gabref/TCC/diversos/base-Análise estática 1-Resultados-Tensão1.analysis.png

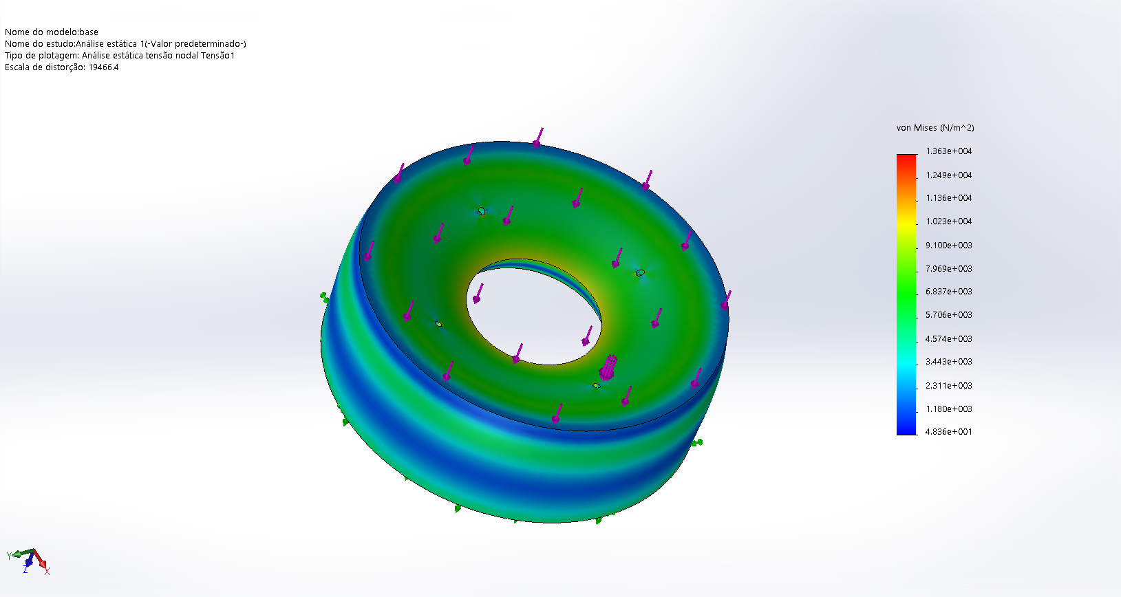
diversos/base-Análise estática 1-Resultados-Tensão1.analysis.png
