gabref/TCC/diversos/Análise estática Braço 200mm-Resultados-Deslocamento1.analysis.png

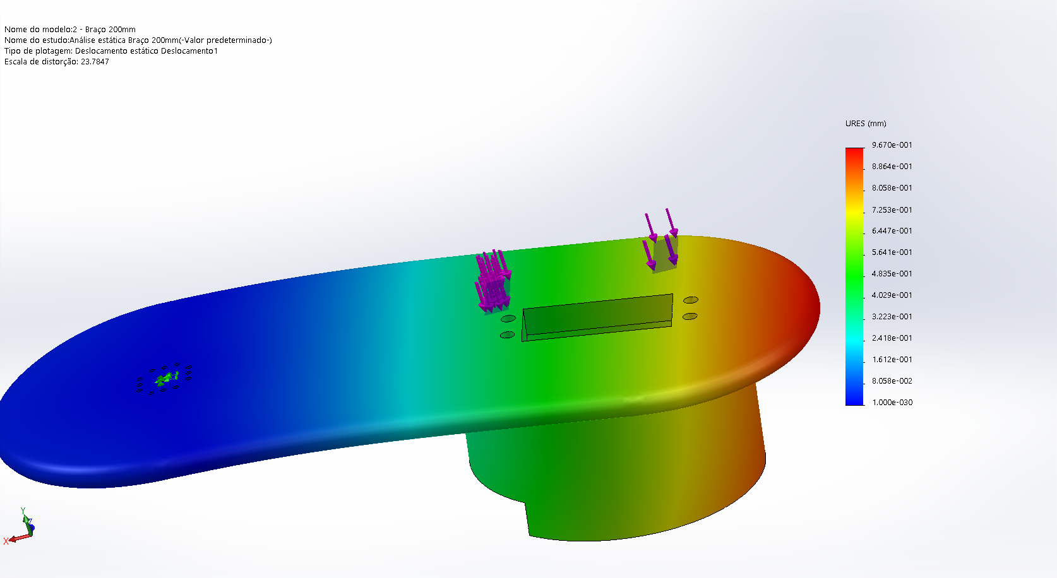
diversos/Análise estática Braço 200mm-Resultados-Deslocamento1.analysis.png
