gabref/TCC/README.md

# TCC
TCC de Mecatrônica - Colégio Técnico Opção (2017)
##
Para ler o PDF do TCC, acessar o link: [Pasta Entregue](https://github.com/gabref/TCC/blob/main/Pasta%20Entregue.pdf)

## Vídeo demonstrando o funcionamento do programa Desktop para controlar o Robô Scara-D

https://user-images.githubusercontent.com/83483325/134989432-be1a48b4-38d2-438e-9cfa-d54873dcd93e.mp4
