gabref/TCC/Desenhos Aprovados/Base da Coluna.jpg

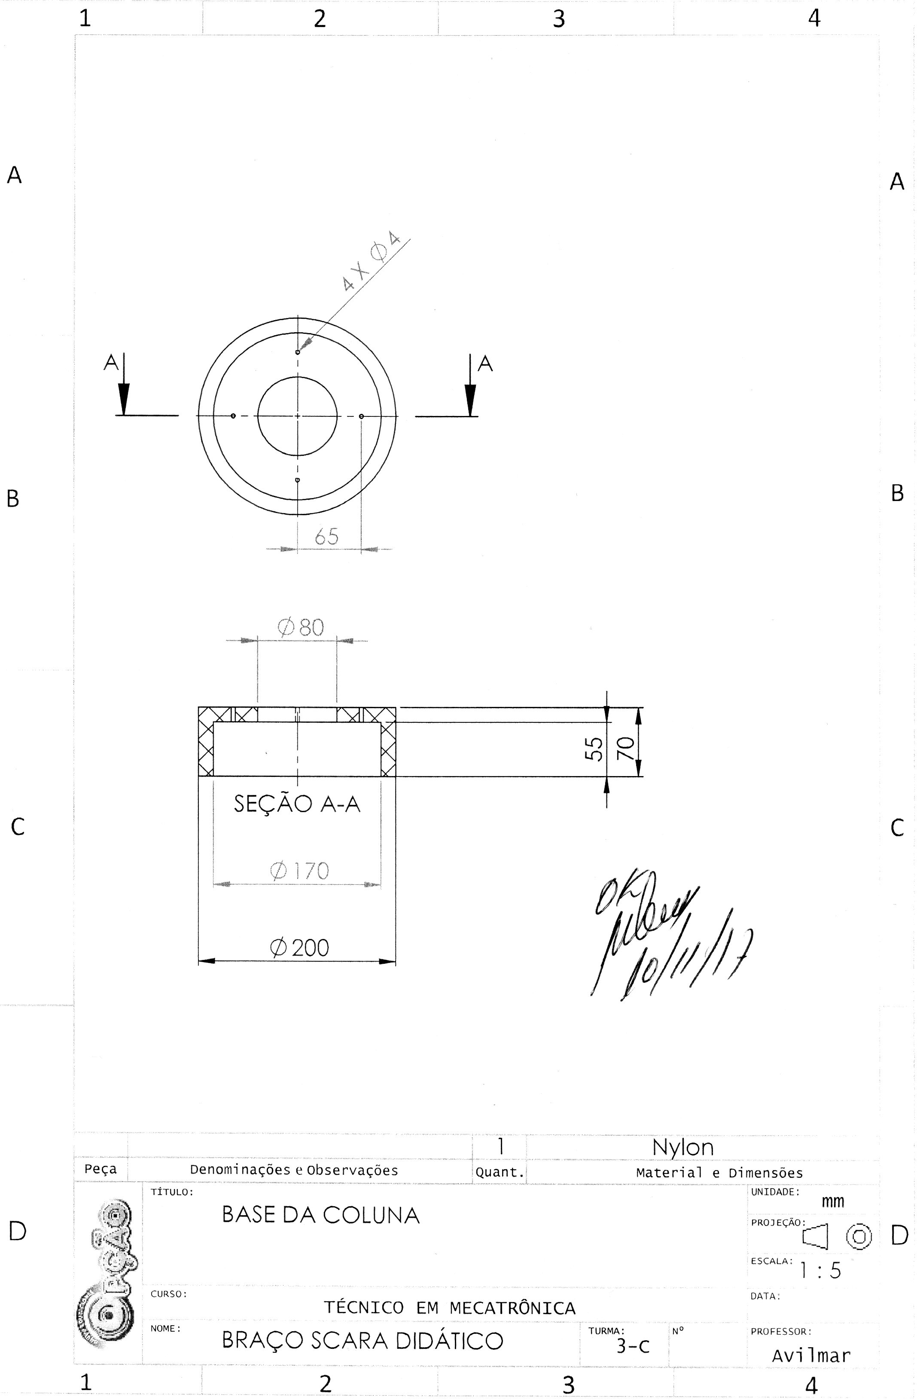
Desenhos Aprovados/Base da Coluna.jpg
