gabref/TCC/Desenhos Aprovados/Base Guarra.jpg

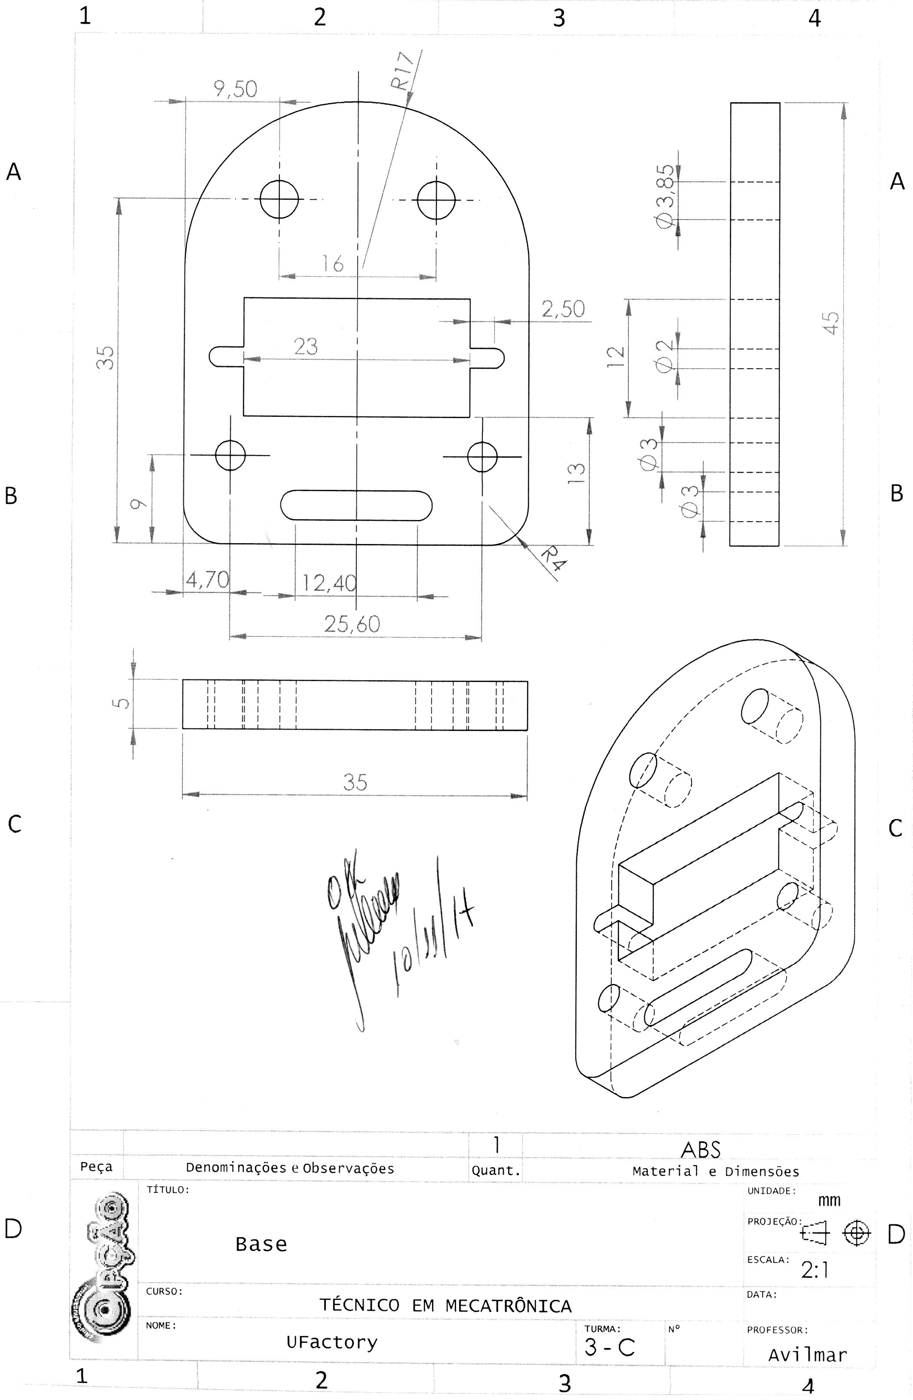
Desenhos Aprovados/Base Guarra.jpg
