gabref/TCC/Desenhos Aprovados/Circuito Elétrico.jpg

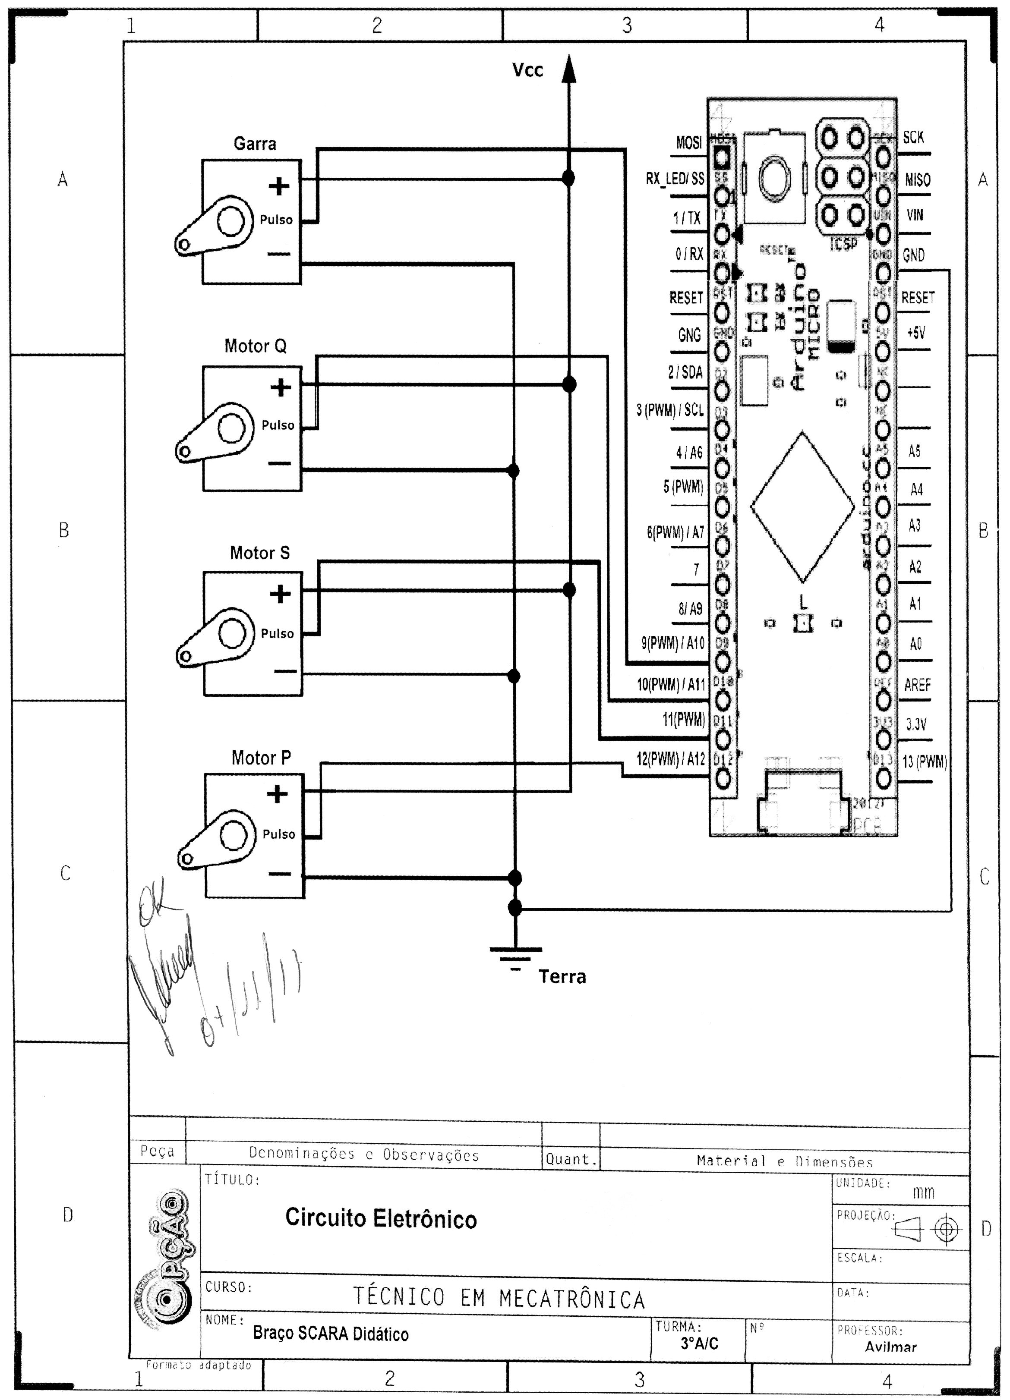
Desenhos Aprovados/Circuito Elétrico.jpg
