gabref/TCC/Desenhos Aprovados/Coluna.jpg

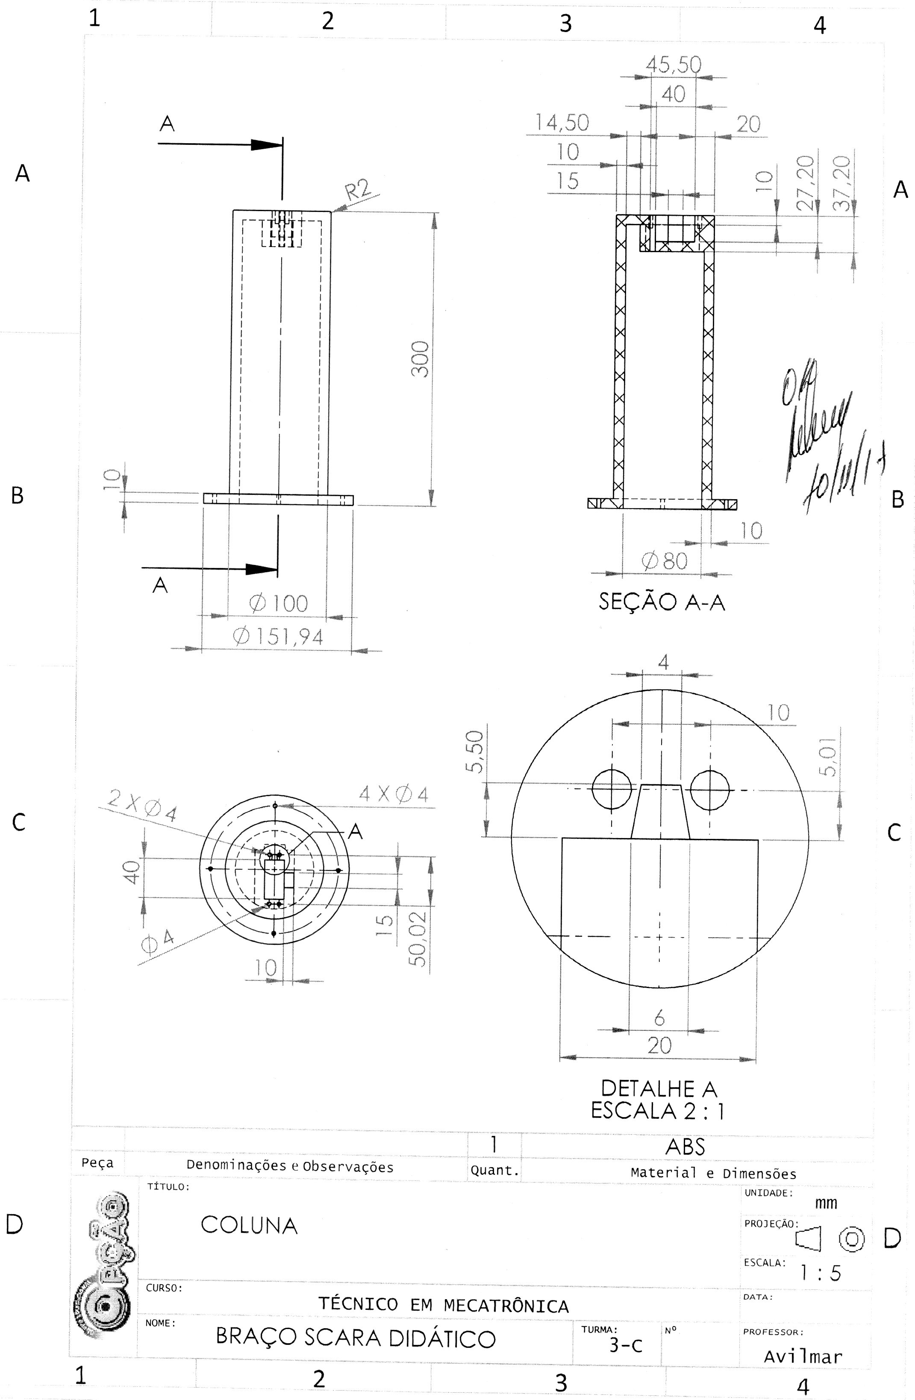
Desenhos Aprovados/Coluna.jpg
