gabref/TCC/Desenhos Aprovados/Conector da Garra.jpg

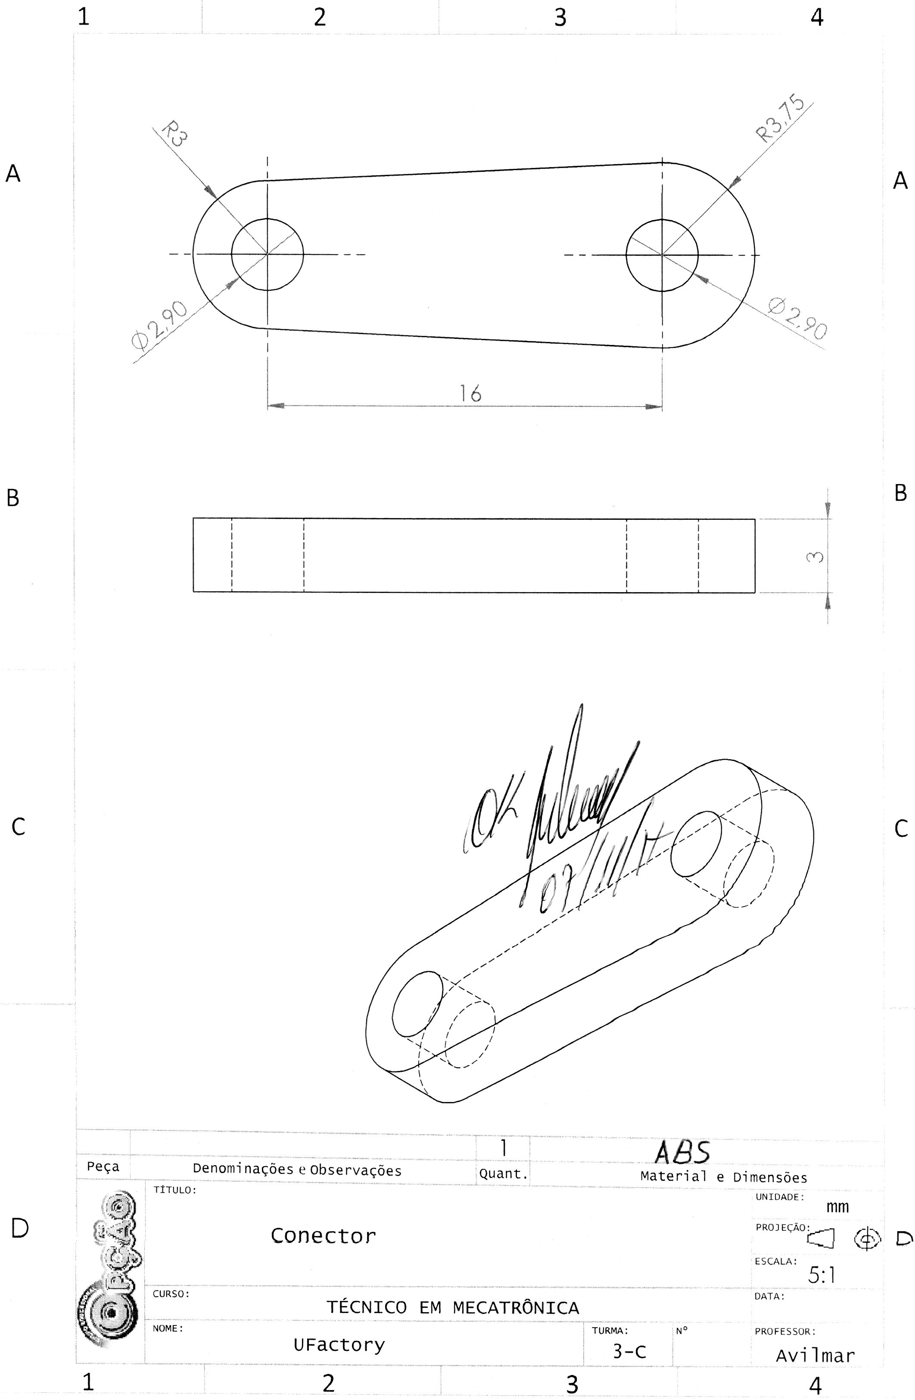
Desenhos Aprovados/Conector da Garra.jpg
