gabref/TCC/Desenhos Aprovados/Corpo da Junta Prismática.jpg

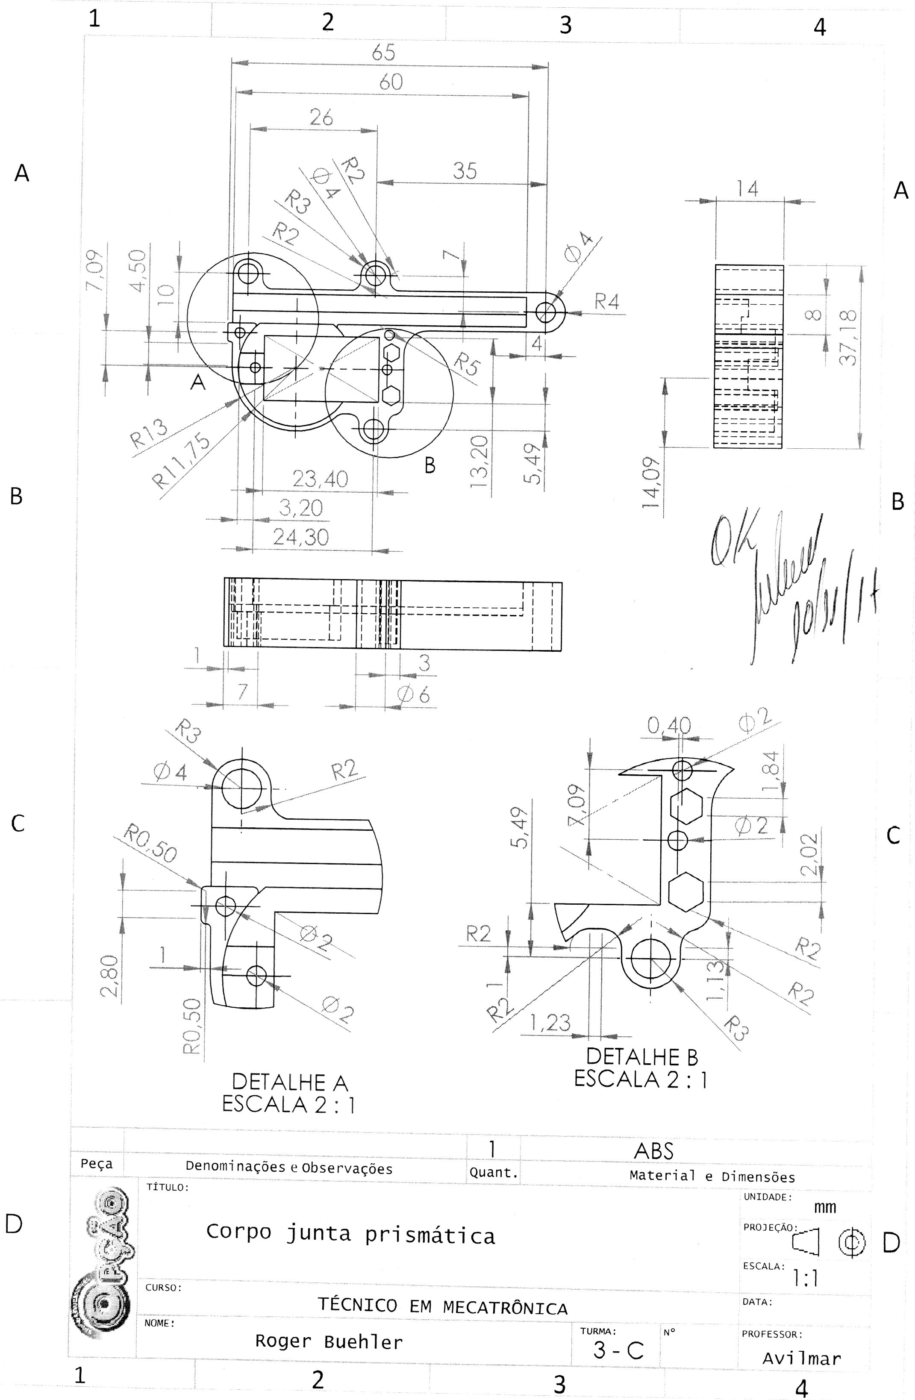
Desenhos Aprovados/Corpo da Junta Prismática.jpg
