gabref/TCC/Desenhos Aprovados/Cremalheira.jpg

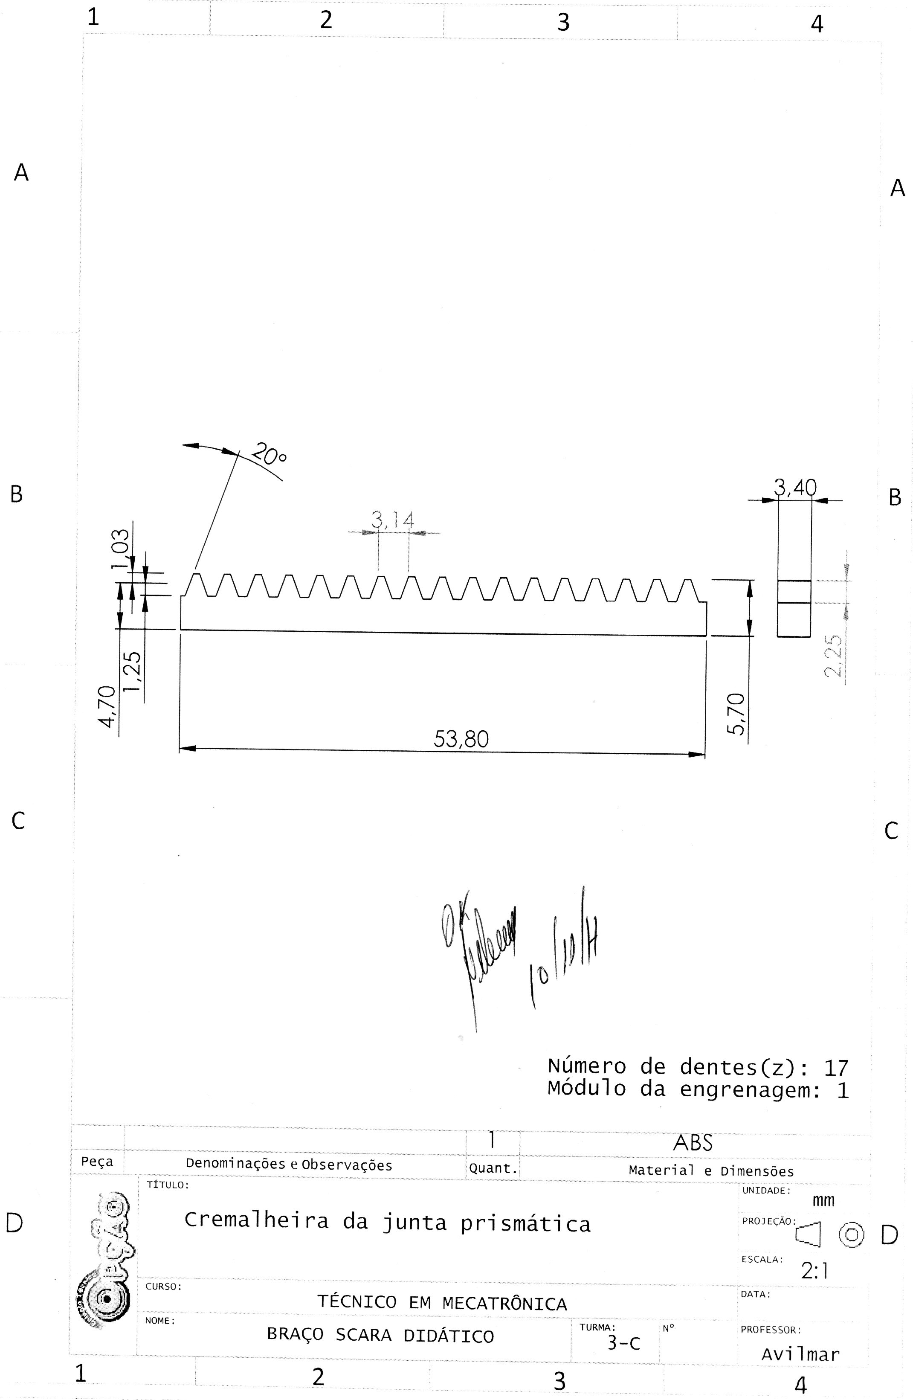
Desenhos Aprovados/Cremalheira.jpg
