gabref/TCC/Desenhos Aprovados/Elo 1.jpg

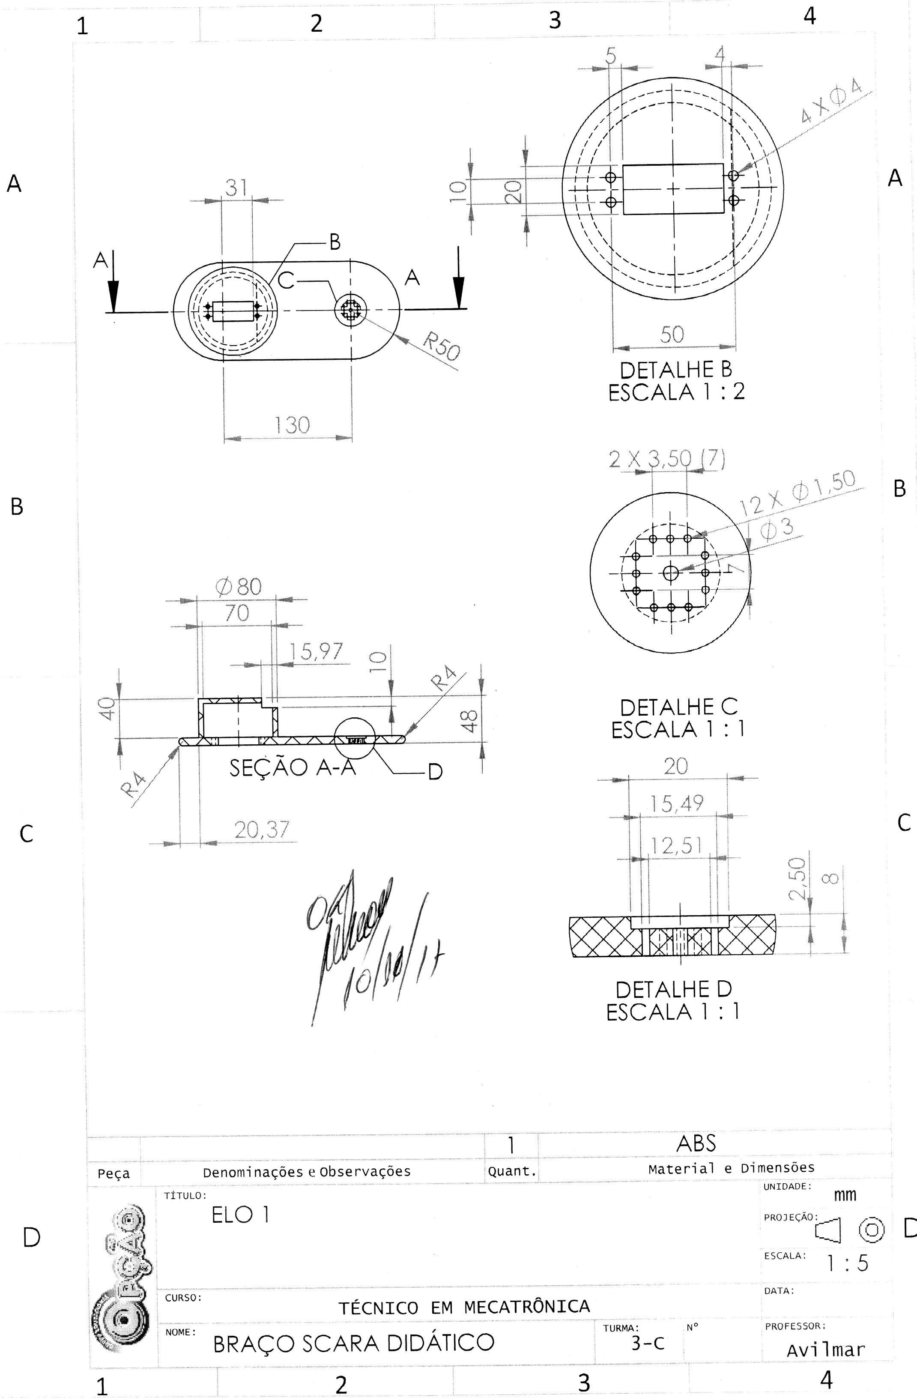
Desenhos Aprovados/Elo 1.jpg
