gabref/TCC/Desenhos Aprovados/Elo 2.jpg

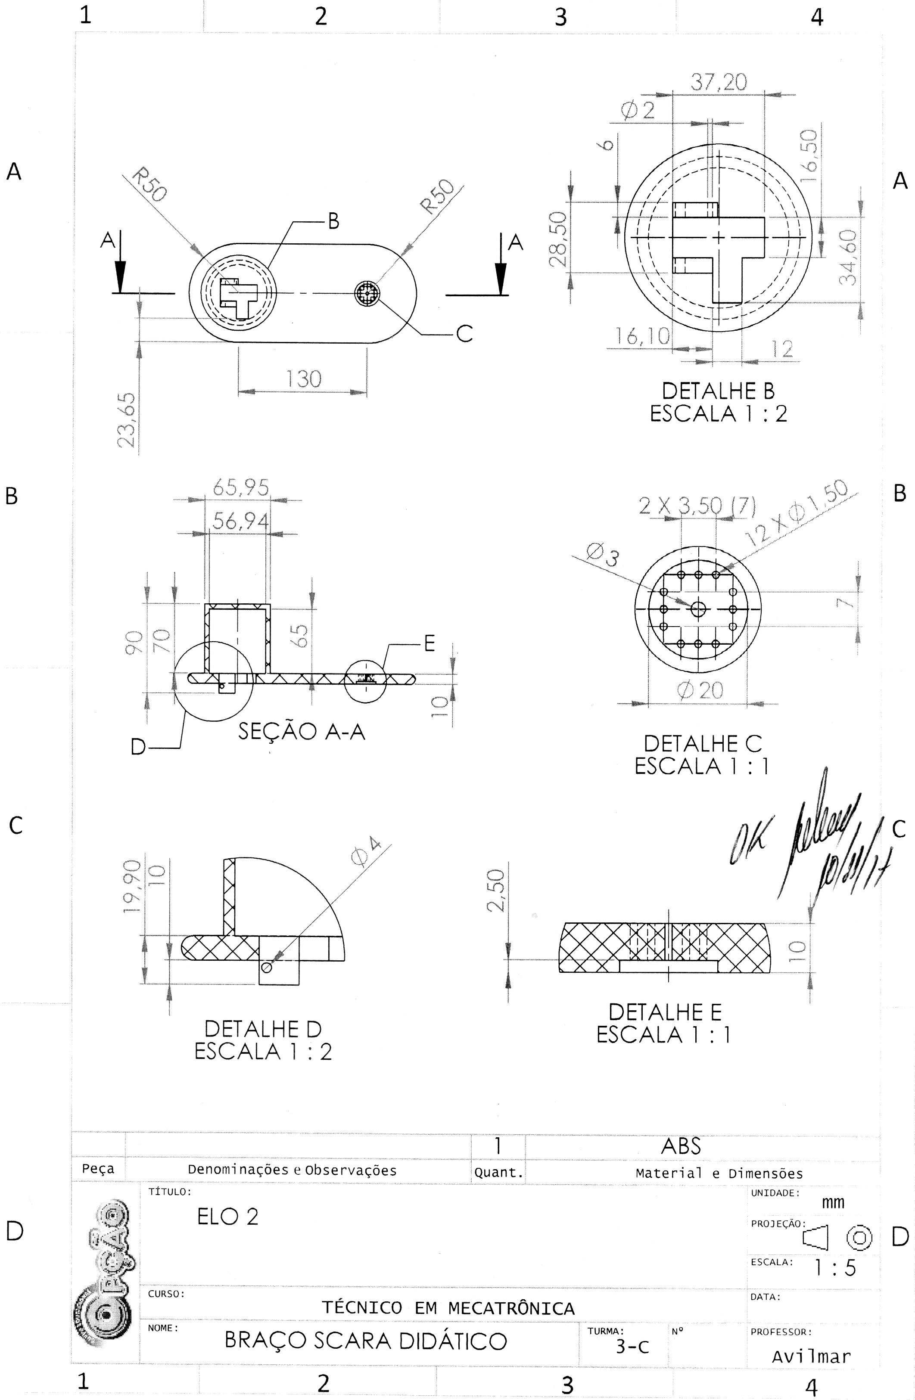
Desenhos Aprovados/Elo 2.jpg
