gabref/TCC/Desenhos Aprovados/Encaixe da Cremalheira.jpg

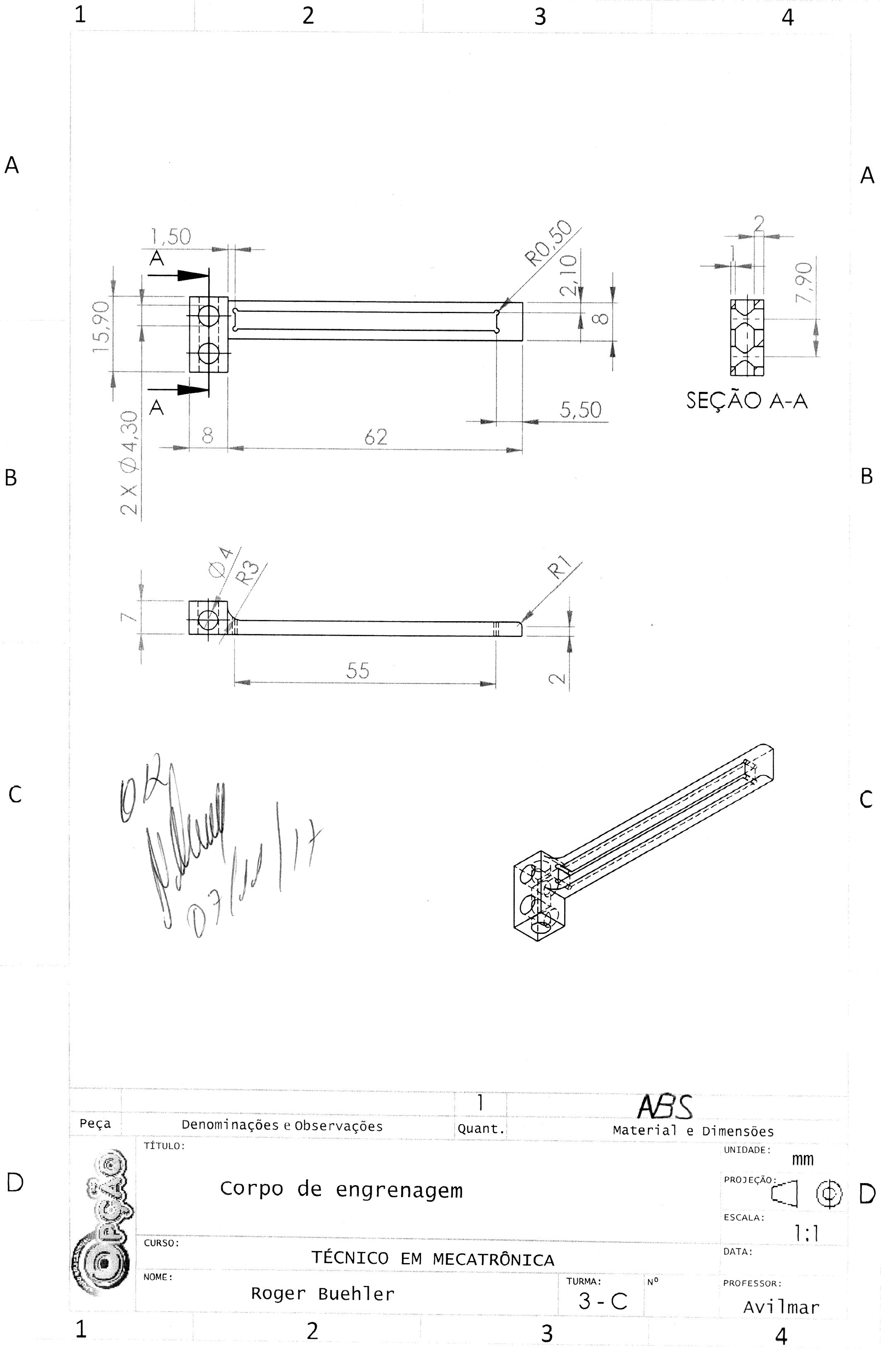
Desenhos Aprovados/Encaixe da Cremalheira.jpg
