gabref/TCC/Desenhos Aprovados/Encaixe da Junta Prismática.jpg

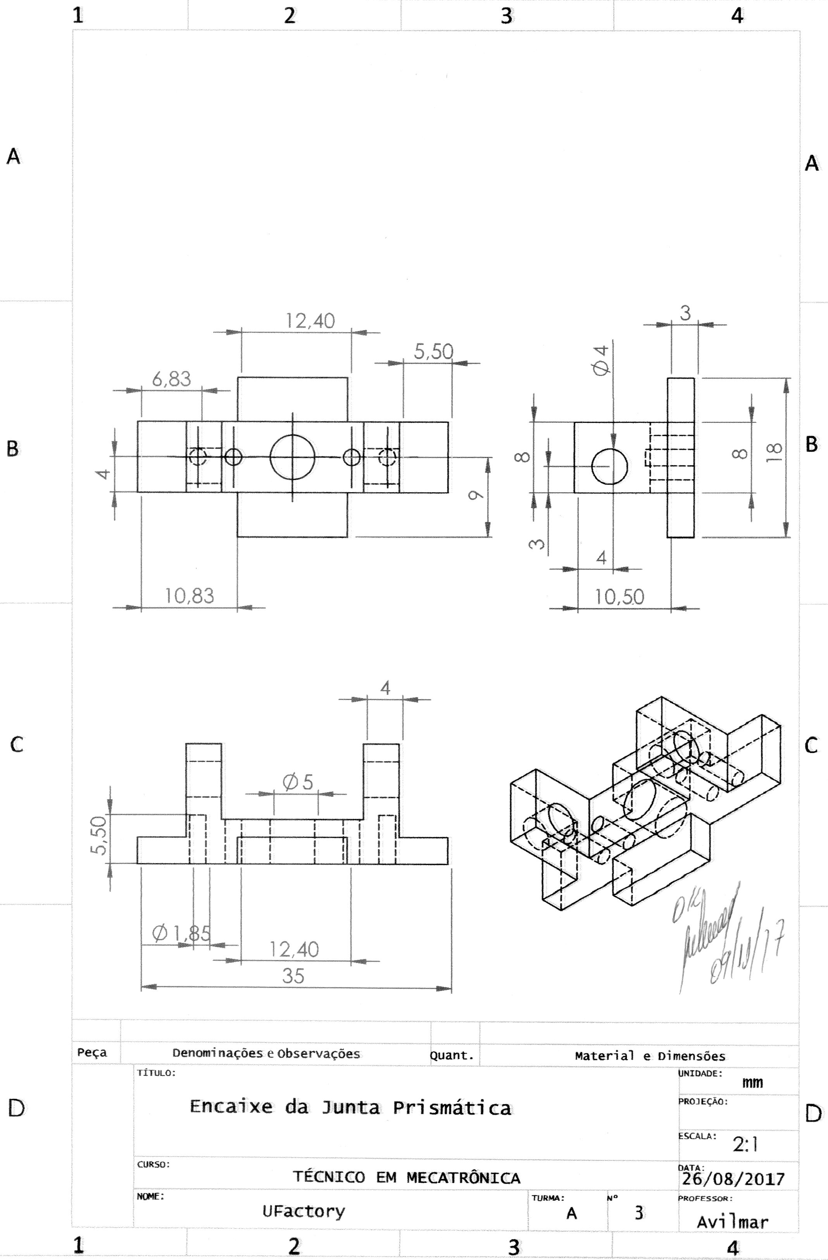
Desenhos Aprovados/Encaixe da Junta Prismática.jpg
