gabref/TCC/Desenhos Aprovados/Engrenagem.jpg

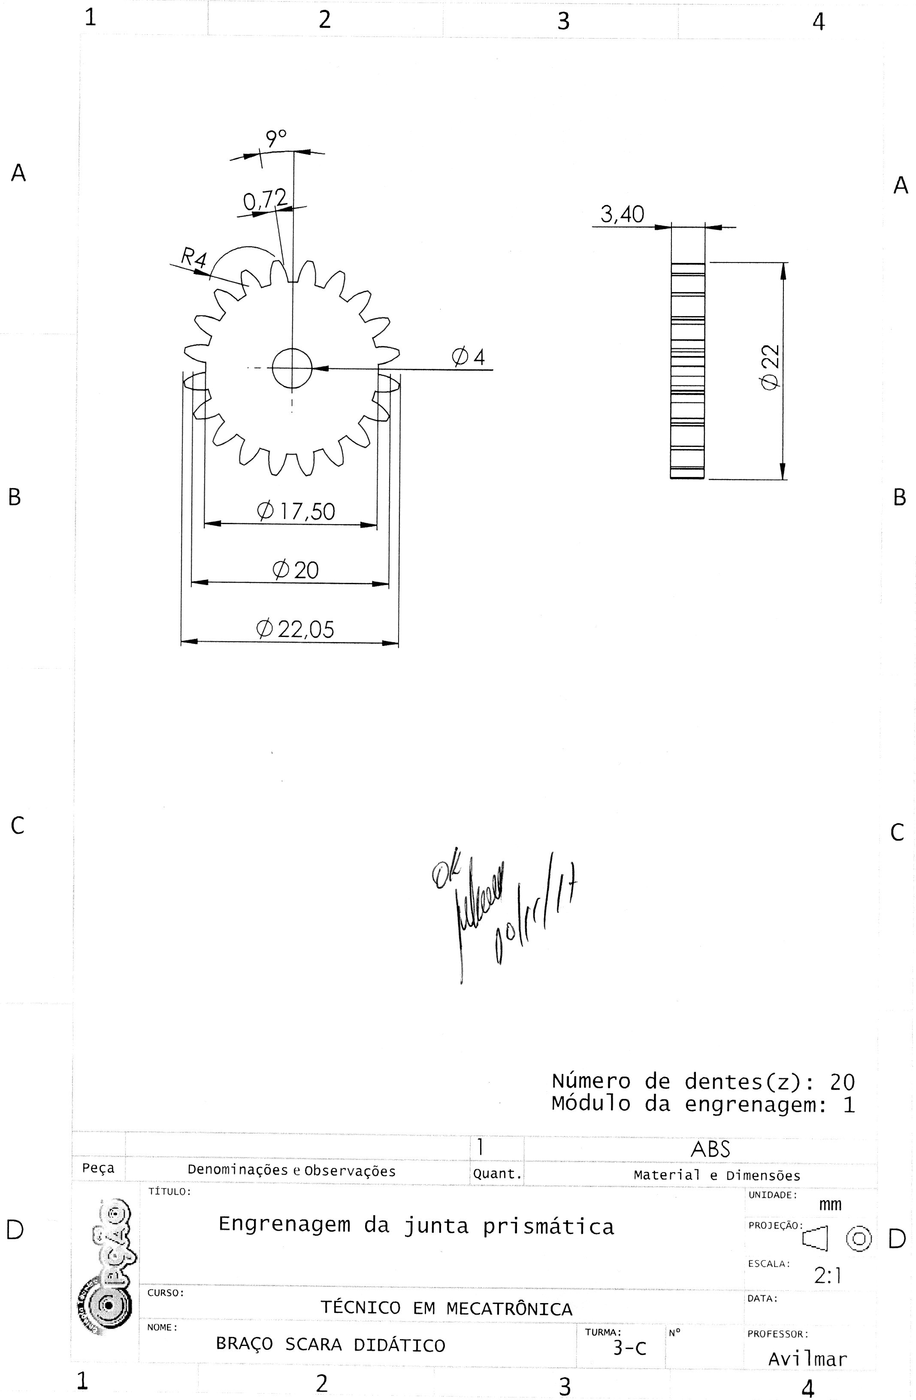
Desenhos Aprovados/Engrenagem.jpg
