gabref/TCC/Desenhos Aprovados/Espaçador da Garra.jpg

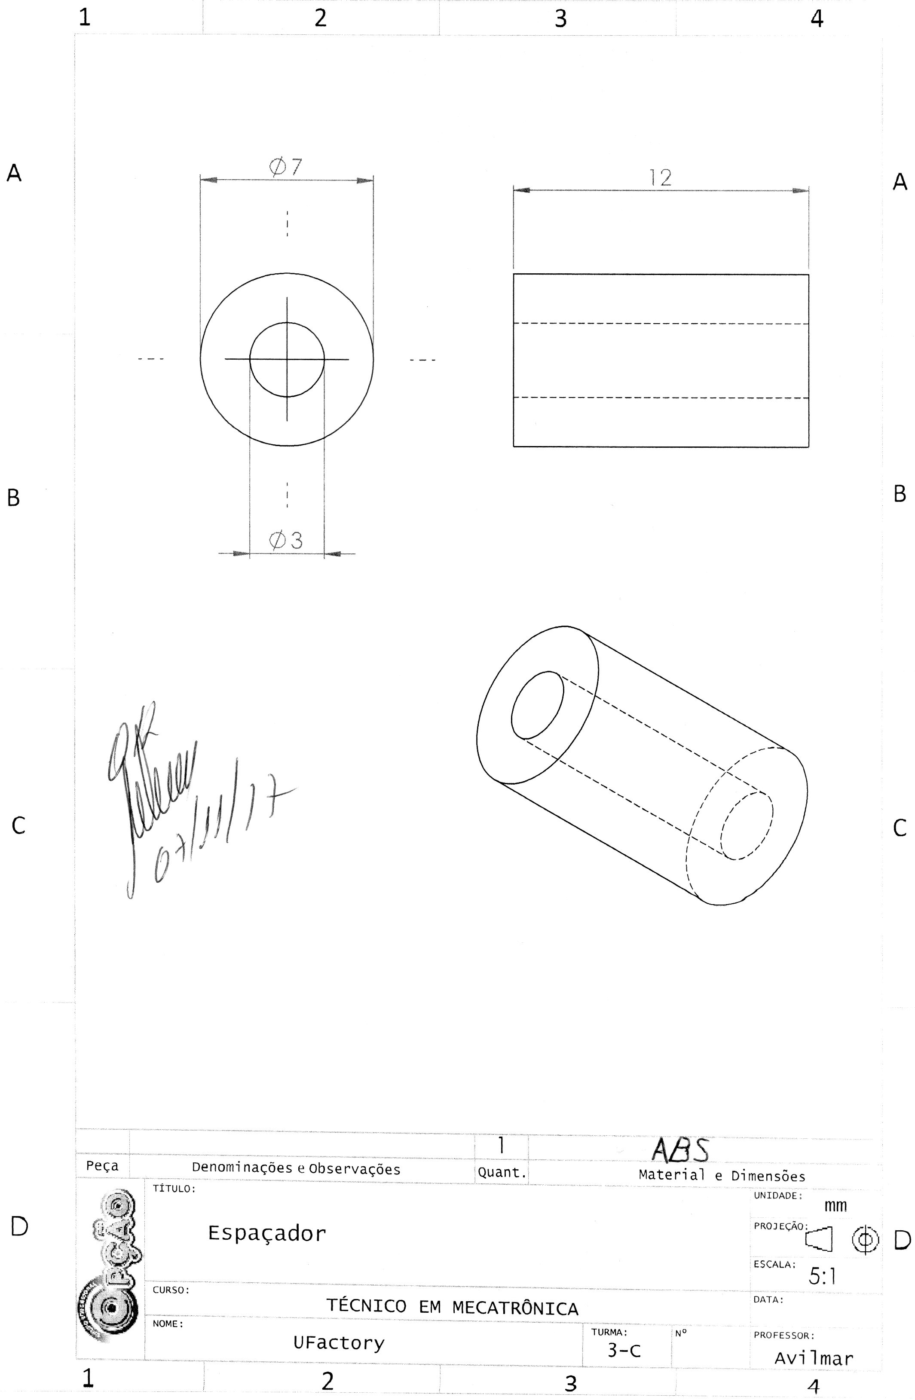
Desenhos Aprovados/Espaçador da Garra.jpg
