gabref/TCC/Desenhos Aprovados/Garra da Coroa.jpg

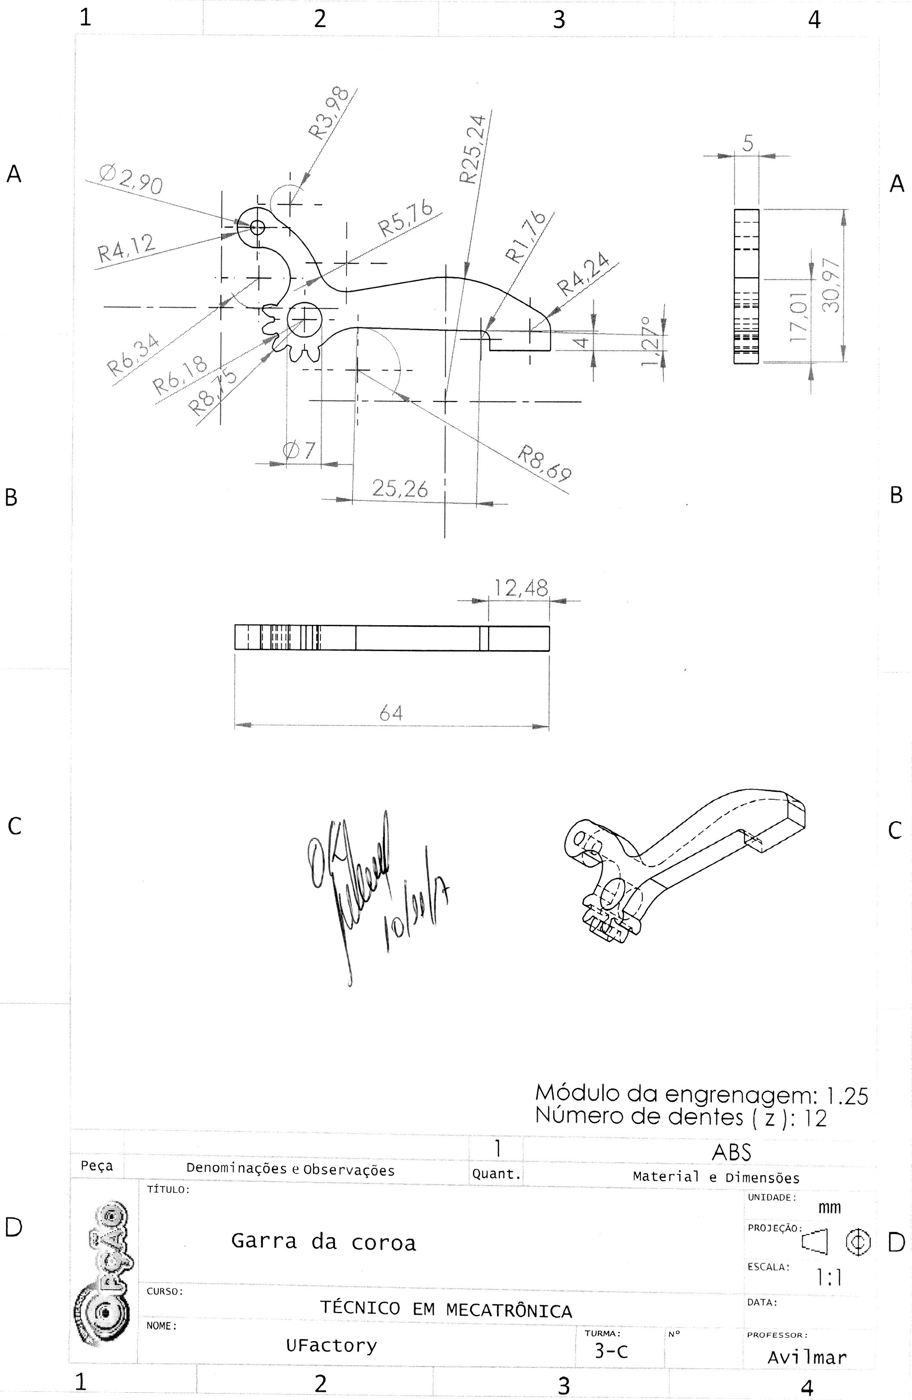
Desenhos Aprovados/Garra da Coroa.jpg
