gabref/TCC/Desenhos Aprovados/Garra do Pinhão.jpg

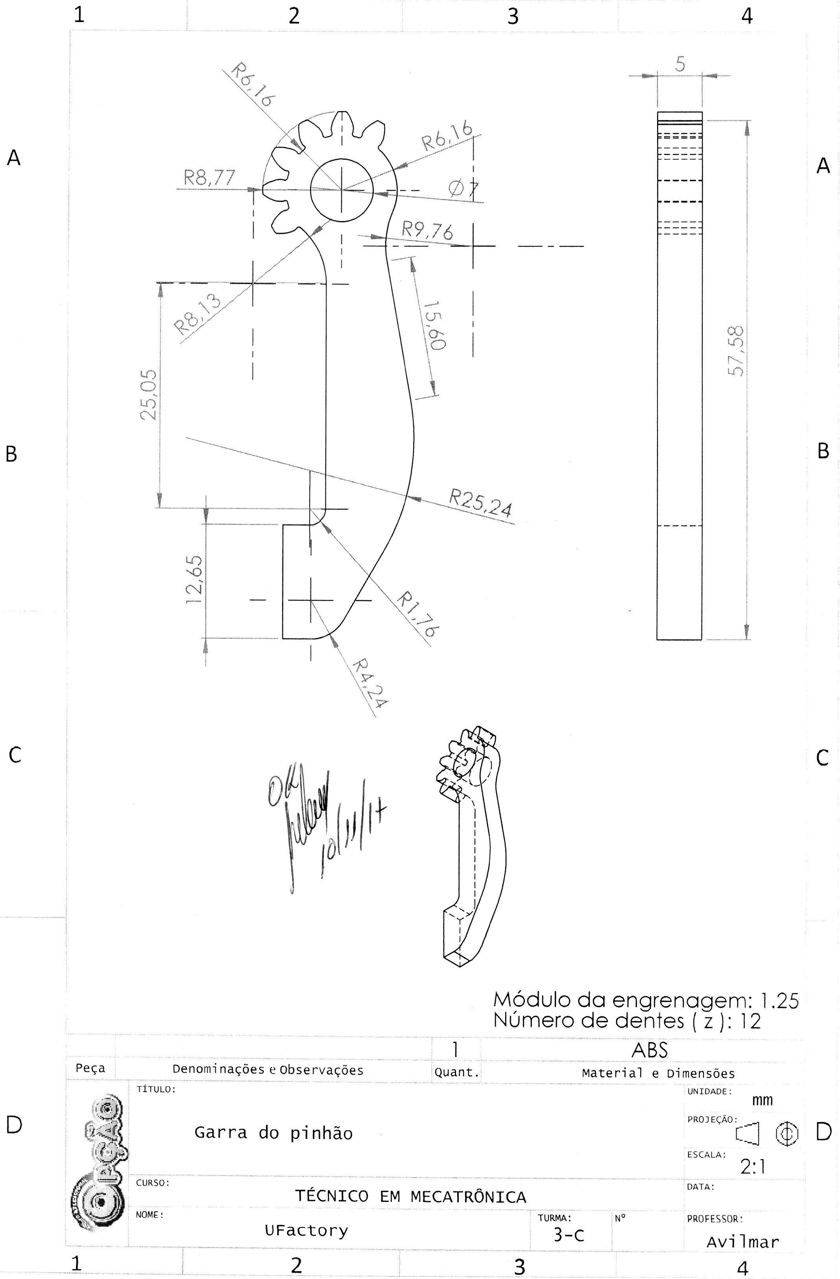
Desenhos Aprovados/Garra do Pinhão.jpg
