gabref/TCC/Desenhos Aprovados/Hélice Servo Motor.jpg

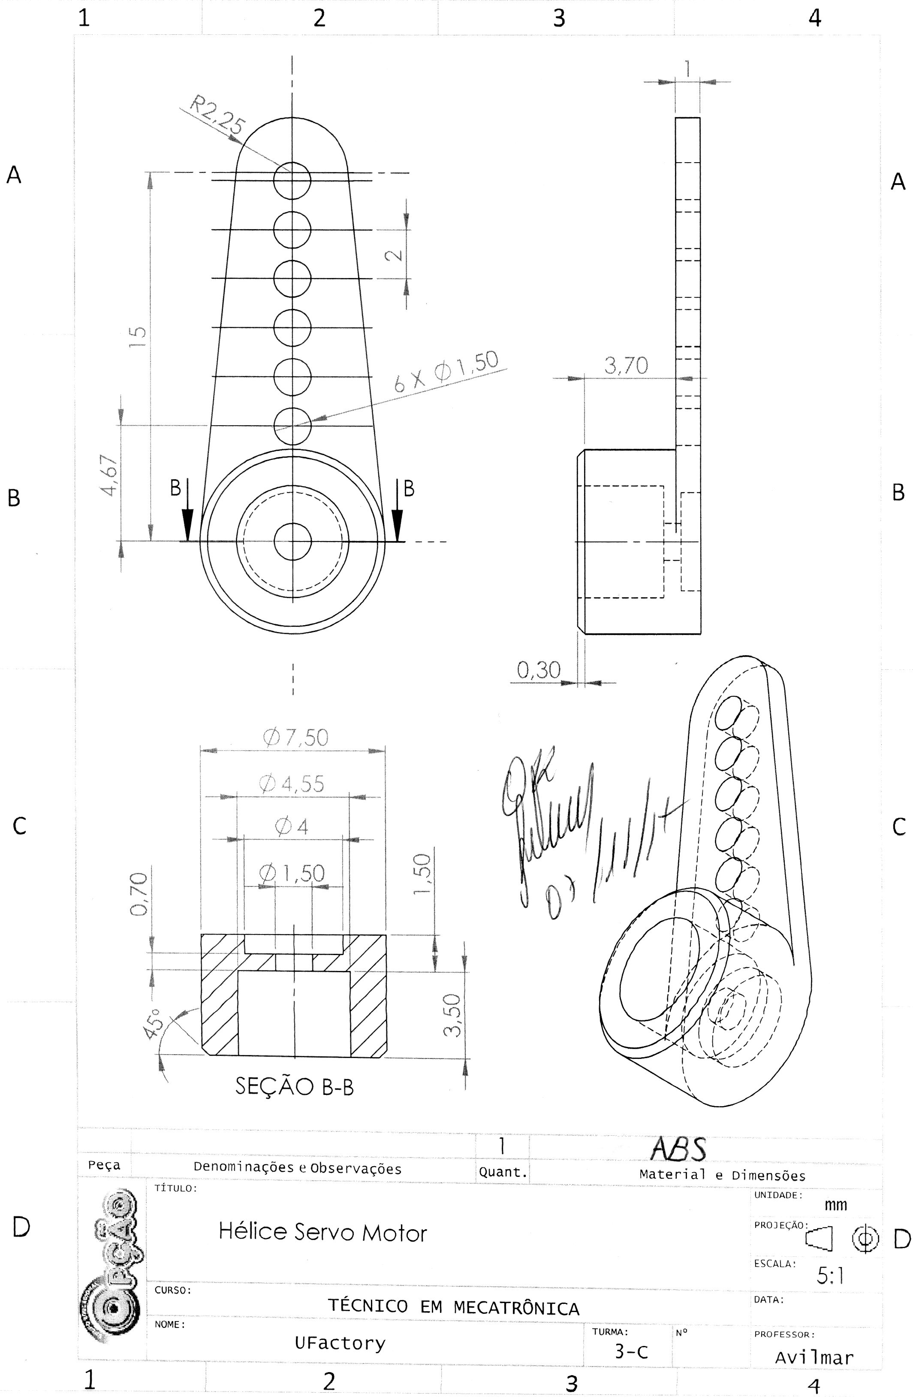
Desenhos Aprovados/Hélice Servo Motor.jpg
