gabref/TCC/Desenhos Aprovados/SCARA-D.jpg

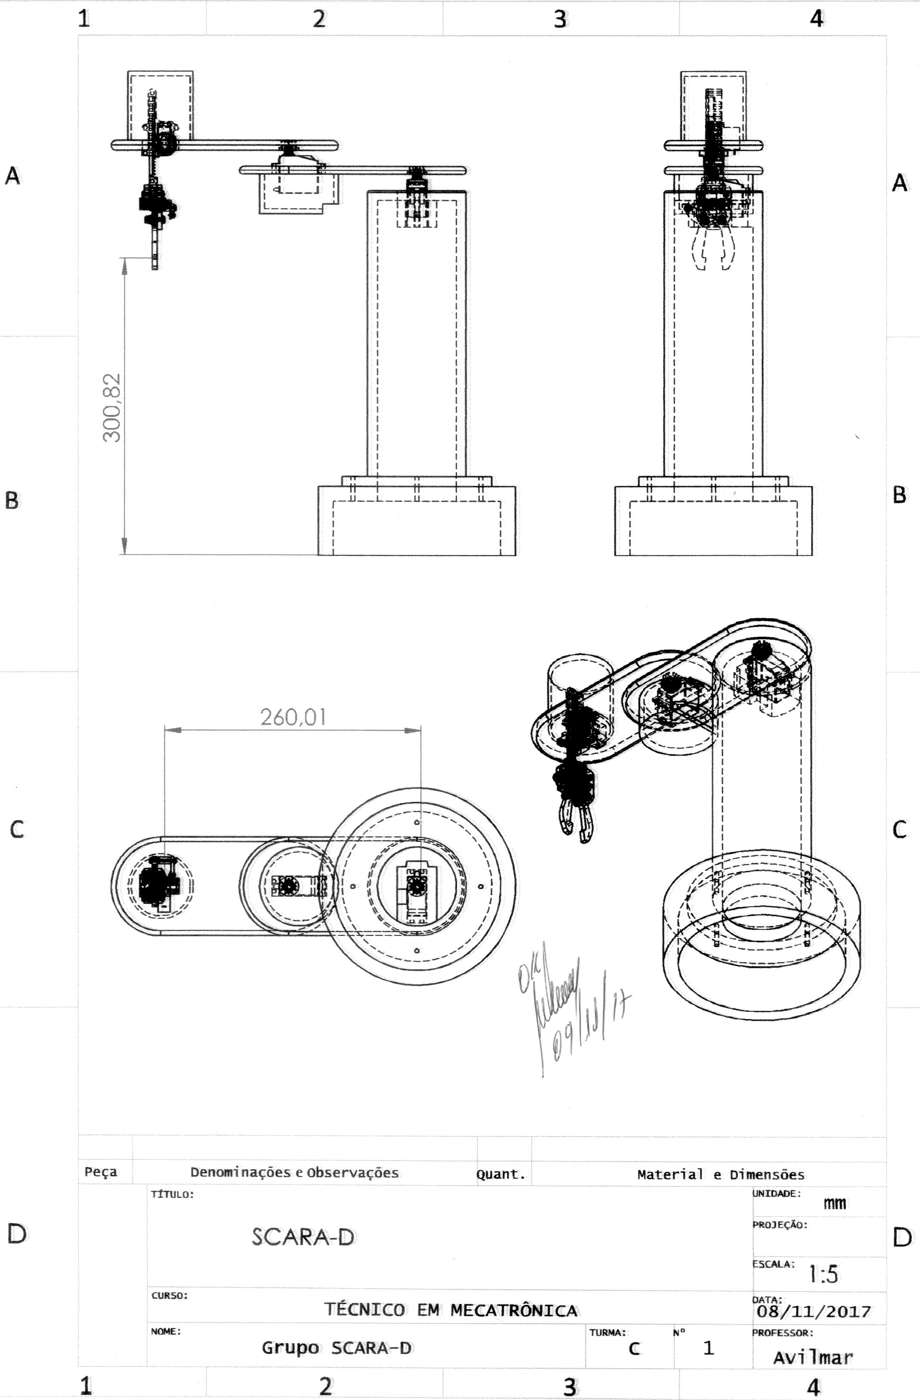
Desenhos Aprovados/SCARA-D.jpg
