gabref/TCC/Desenhos Aprovados/Suporte M3x8.jpg

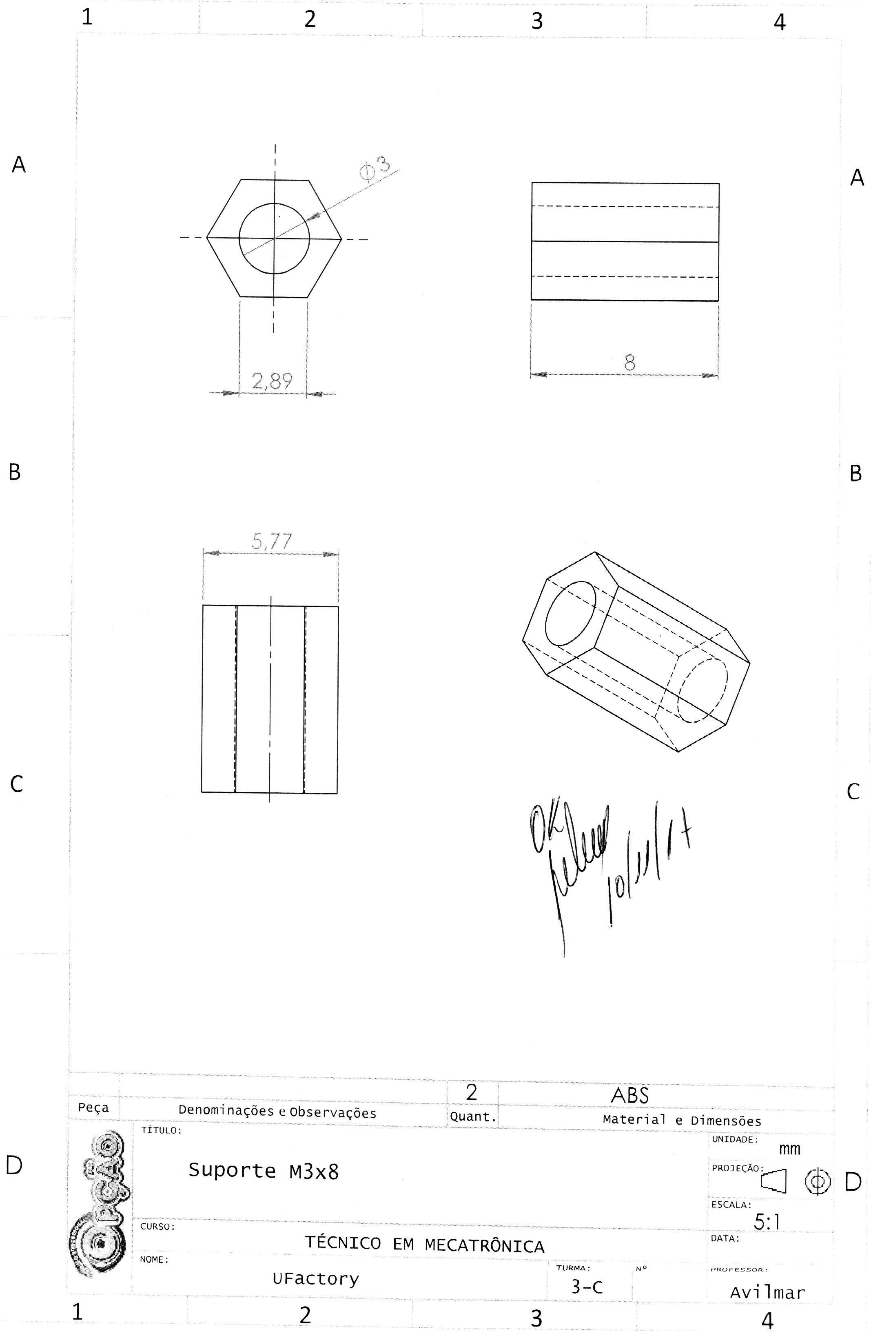
Desenhos Aprovados/Suporte M3x8.jpg
