gabref/TCC/Desenhos Aprovados/Suporte Servo.jpg

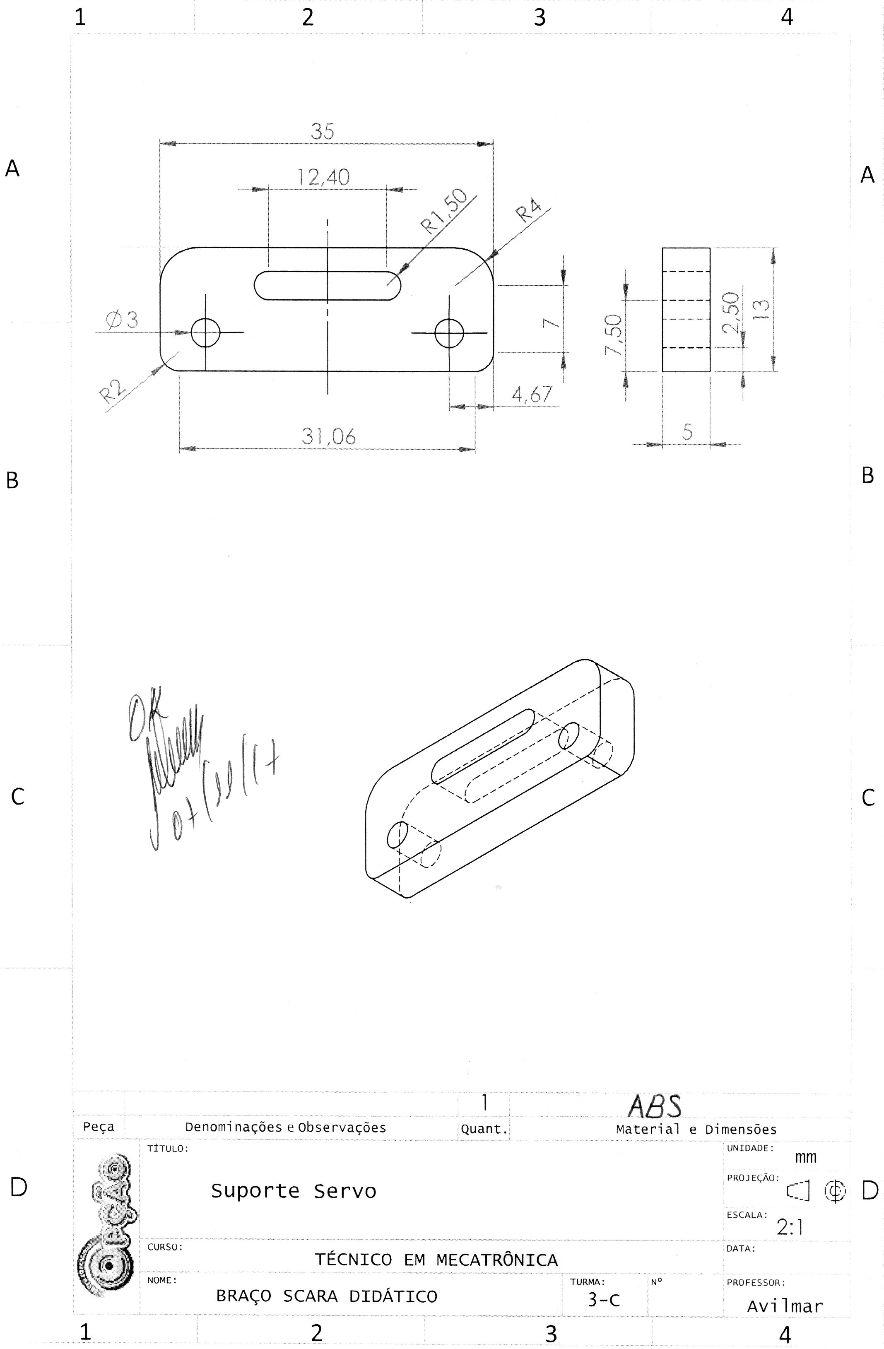
Desenhos Aprovados/Suporte Servo.jpg
