gabref/TCC/Desenhos Aprovados/Tampa da Junta Prismática.jpg

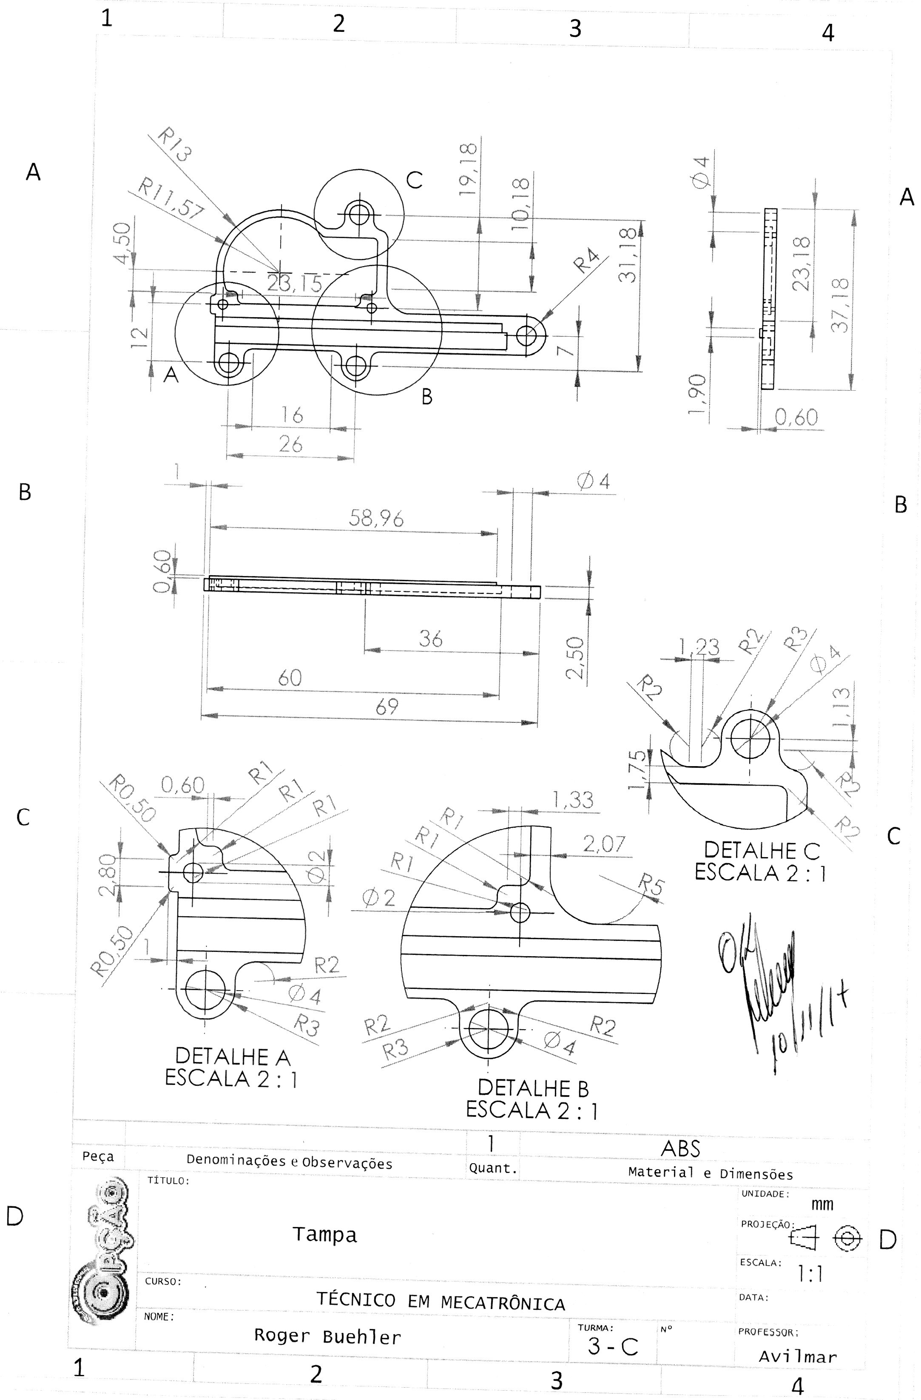
Desenhos Aprovados/Tampa da Junta Prismática.jpg
