gabref/TCC/diversos/ABAAAelzkAC-15.jpg

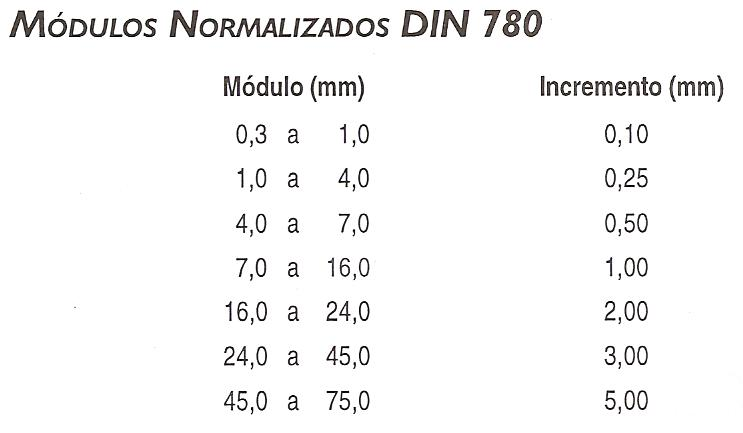
diversos/ABAAAelzkAC-15.jpg
