gabref/TCC/diversos/Analise_Tensao_braco200mm.PNG

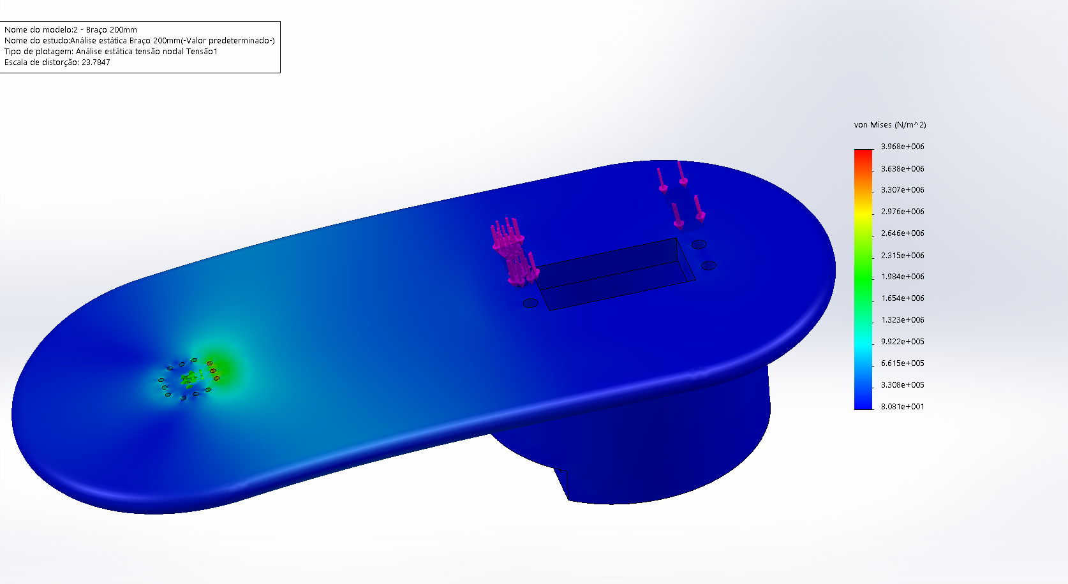
diversos/Analise_Tensao_braco200mm.PNG
