gabref/TCC/diversos/Análise_Tensao_braco300mm.PNG

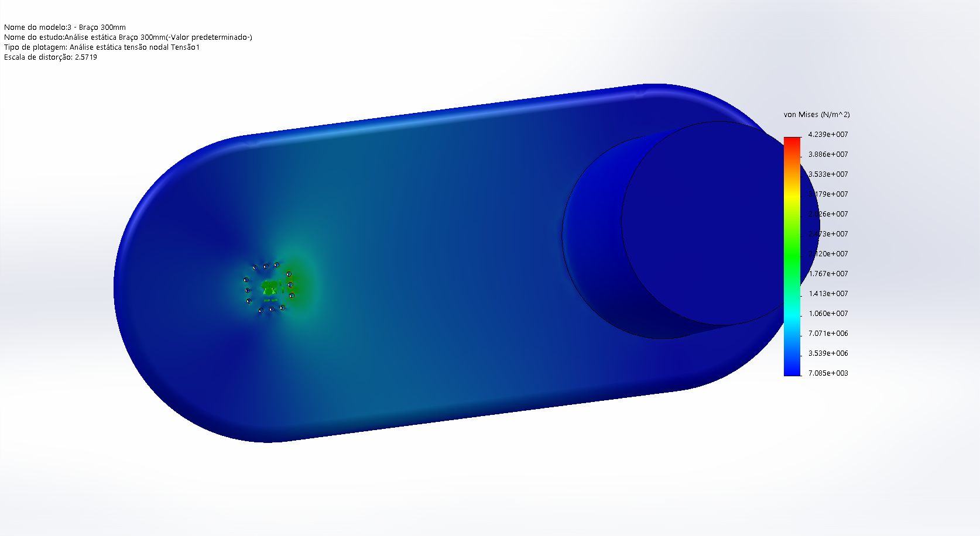
diversos/Análise_Tensao_braco300mm.PNG
