gabref/TCC/diversos/Cinemática direta e indireta.PNG

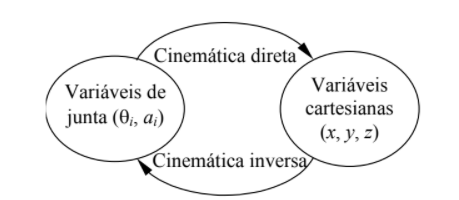
diversos/Cinemática direta e indireta.PNG
