gabref/TCC/diversos/Cremalheira.PNG

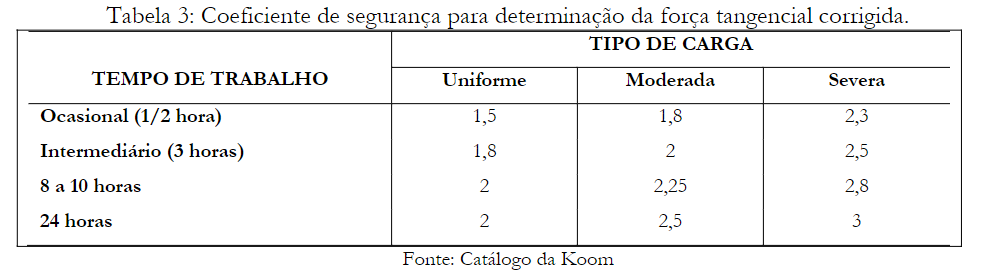
diversos/Cremalheira.PNG
