gabref/TCC/diversos/desenho-tcnico-mecnico-aula-13-15-638.jpg

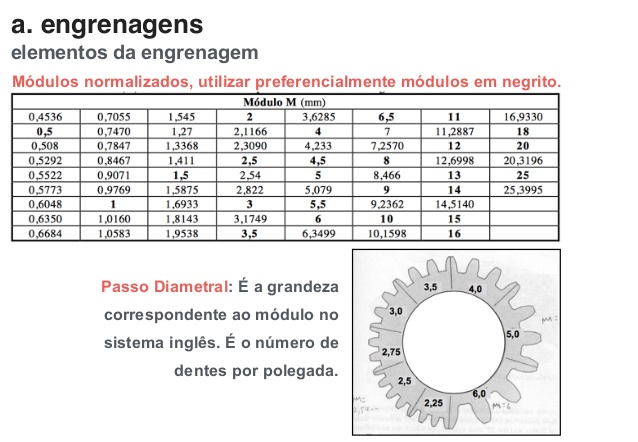
diversos/desenho-tcnico-mecnico-aula-13-15-638.jpg
