gabref/TCC/diversos/engrenagens_image002_0002.jpg

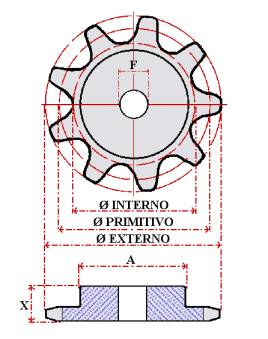
diversos/engrenagens_image002_0002.jpg
