gabref/TCC/diversos/Garra com encaixe atualizado1.PNG

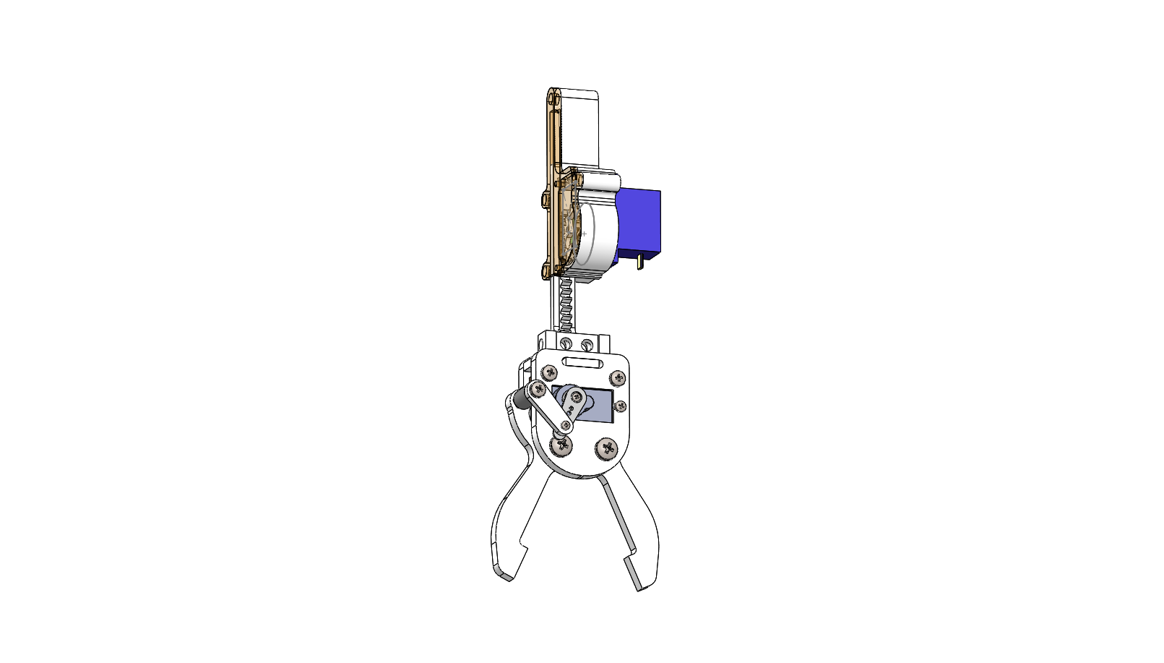
diversos/Garra com encaixe atualizado1.PNG
