gabref/TCC/diversos/garra oposto.PNG

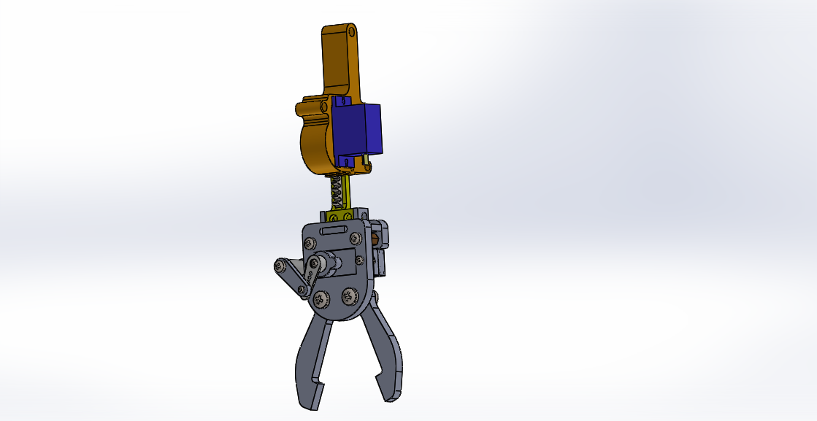
diversos/garra oposto.PNG
