gabref/TCC/diversos/Interface.PNG

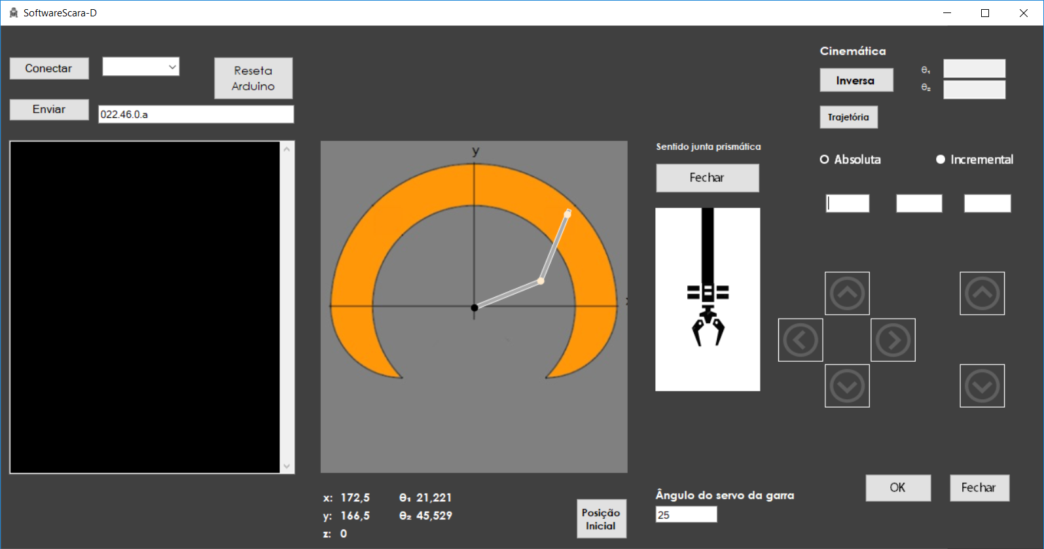
diversos/Interface.PNG
