gabref/TCC/diversos/Junta Prismática.PNG

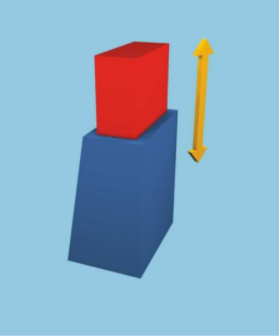
diversos/Junta Prismática.PNG
