gabref/TCC/diversos/Junta Torcional.PNG

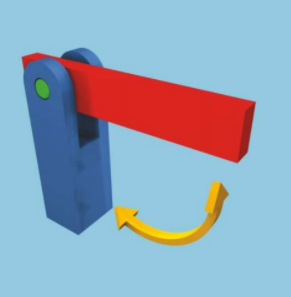
diversos/Junta Torcional.PNG
