gabref/TCC/diversos/Lagrangiano.png

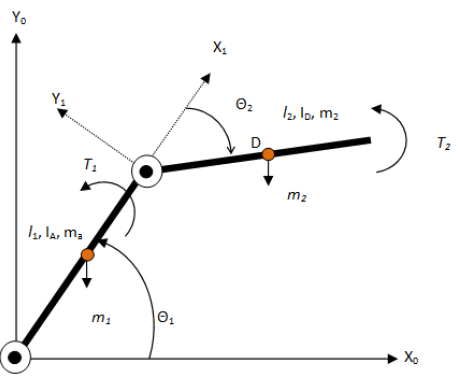
diversos/Lagrangiano.png
