gabref/TCC/diversos/Proton_Rev2.PNG

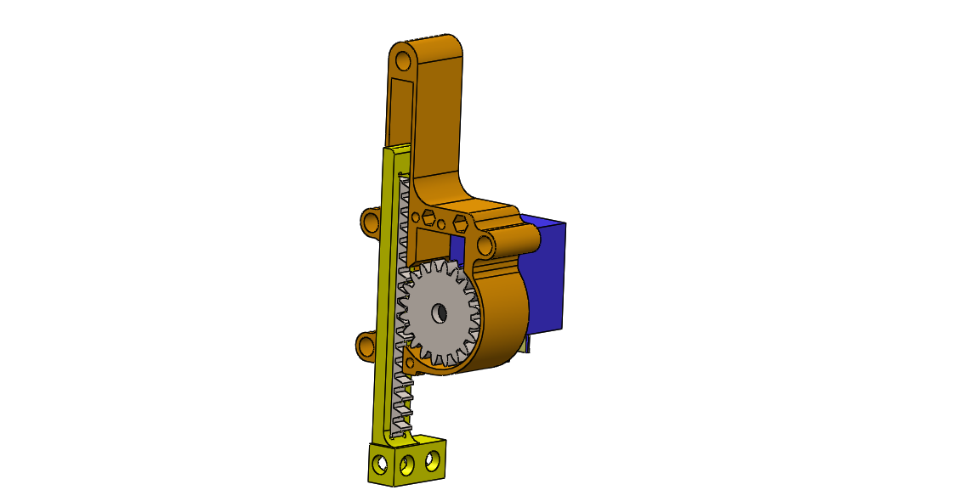
diversos/Proton_Rev2.PNG
