gabref/TCC/diversos/Redundância no robot RR planar.PNG

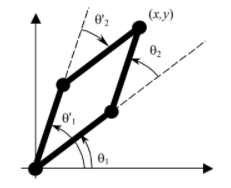
diversos/Redundância no robot RR planar.PNG
