gabref/TCC/diversos/Robot Scara corte.PNG

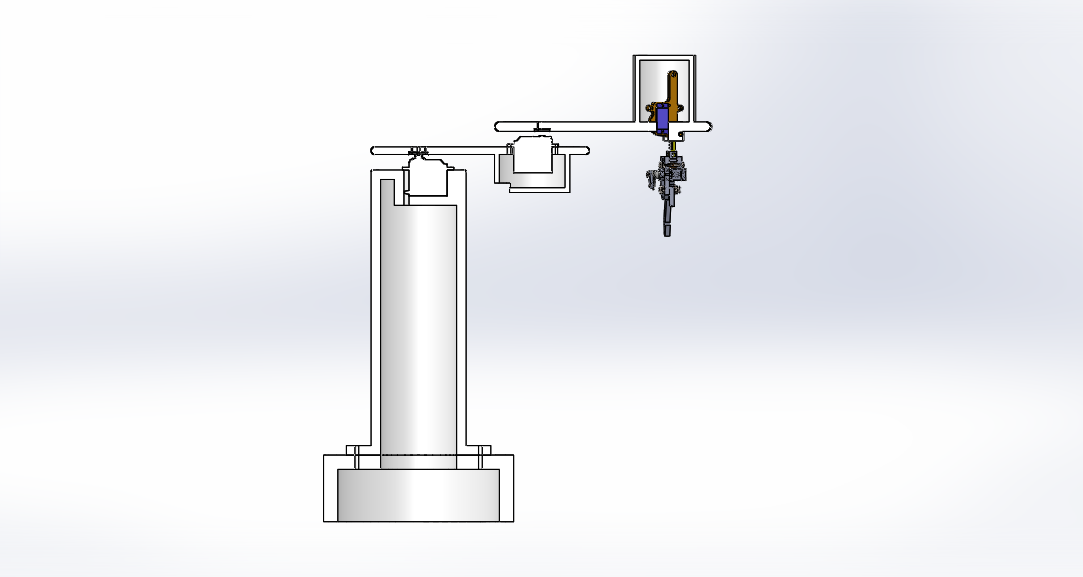
diversos/Robot Scara corte.PNG
