gabref/TCC/diversos/Robot Scara.PNG

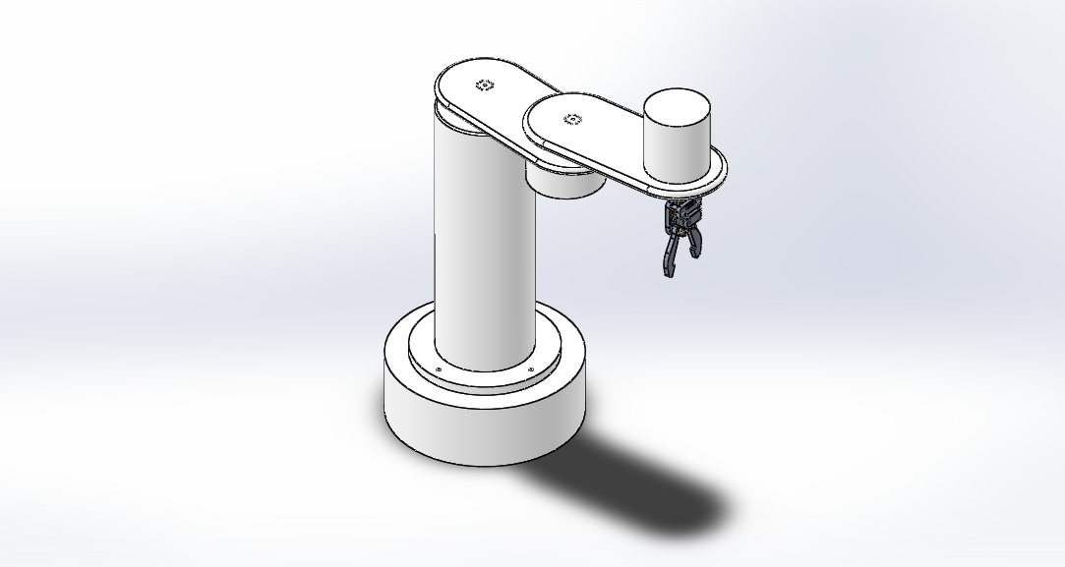
diversos/Robot Scara.PNG
