gabref/TCC/diversos/Scara thetas.PNG

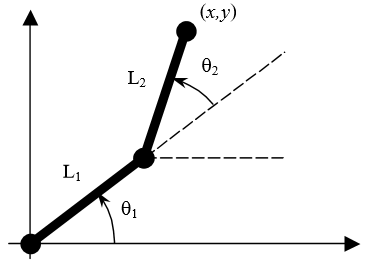
diversos/Scara thetas.PNG
