gabref/TCC/diversos/scara volume.jpg

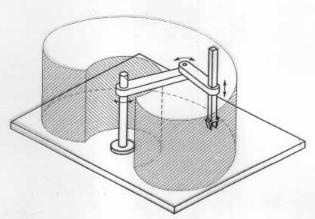
diversos/scara volume.jpg
