gabref/TCC/diversos/scara-d.PNG

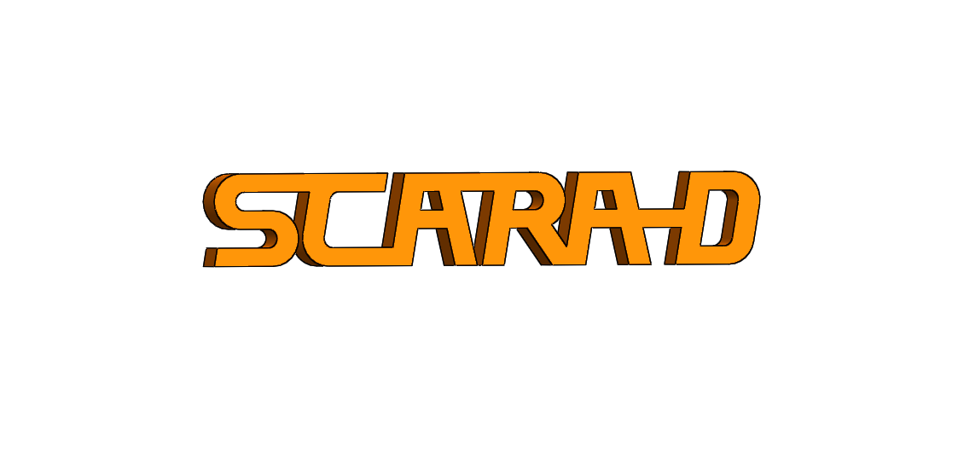
diversos/scara-d.PNG
