gabref/TCC/diversos/WhatsApp Image 2017-11-10 at 02.40.01.jpeg

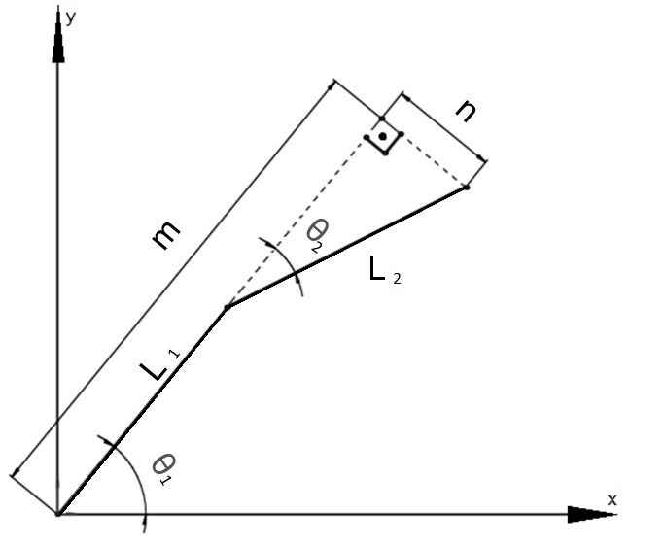
diversos/WhatsApp Image 2017-11-10 at 02.40.01.jpeg
