gabref/TCC/custos.xlsx

ITEM | DESCRIÇÃO | QTD | PREÇO UNITÁRIO | PREÇO TOTAL | FORNECEDOR
1 | Servo motor MG996 | 2 unid. | R$29.90 | R$59.80 | Robô Builders Oficial
2 | Micro Servo SG90 | 2 unid. | R$9.79 | R$19.58 | Persystence
3 | Arduino Micro | 1 unid. | R$35.62 | R$35.62 | Baú da Eletrônica
4 | Fonte de Alimentaçao Chaveada6V-2A Bivolt | 1 unid. | R$19.00 | R$19.00 | Donaribe
5 | Jumper | 14 unid. | R$0.30 | R$4.20 | Ecszinx
6 | Parafuso M4 x 35 | 4 unid. | R$0.40 | R$1.60 | CCP virtual
7 | Parafuso M2 x 10 | 12 unid. | R$0.03 | R$0.35 | CCP virtual
8 | Parafuso M3 x 16 | 2 unid. | R$1.00 | R$2.00 | Mainart JLA
9 | Parafuso M1.6 x 5 | 4 unid. | R$1.50 | R$6.00 | Loja do Optico
10 | Parafuso M4 x 16 | 2 unid. | R$1.40 | R$2.80 | Web Parafusos
11 | Parafuso M3 x 25 | 1 unid. | R$1.80 | R$1.80 | Fixofort
12 | Parafuso M3 x 8 | 4 unid. | R$1.70 | R$6.80 | Ivankpk
13 | Porca M3 | 2 unid. | R$0.05 | R$0.10 | Emaifix
14 | Porca M2 | 2 unid. | R$0.05 | R$0.10 | Emaifix
15 | Porca M4 | 4 unid. | R$0.05 | R$0.20 | Emaifix
16 | Plástico ABS | 1,8 Kg | R$ 96,00 (1kg) | R$172.80 | Makerbot
 |  |  | Custo Total: | R$332.93
