gabref/TCC/diversos/3 - Braço 300mm-Análise estática-Resultados-Tensão1.analysis.png

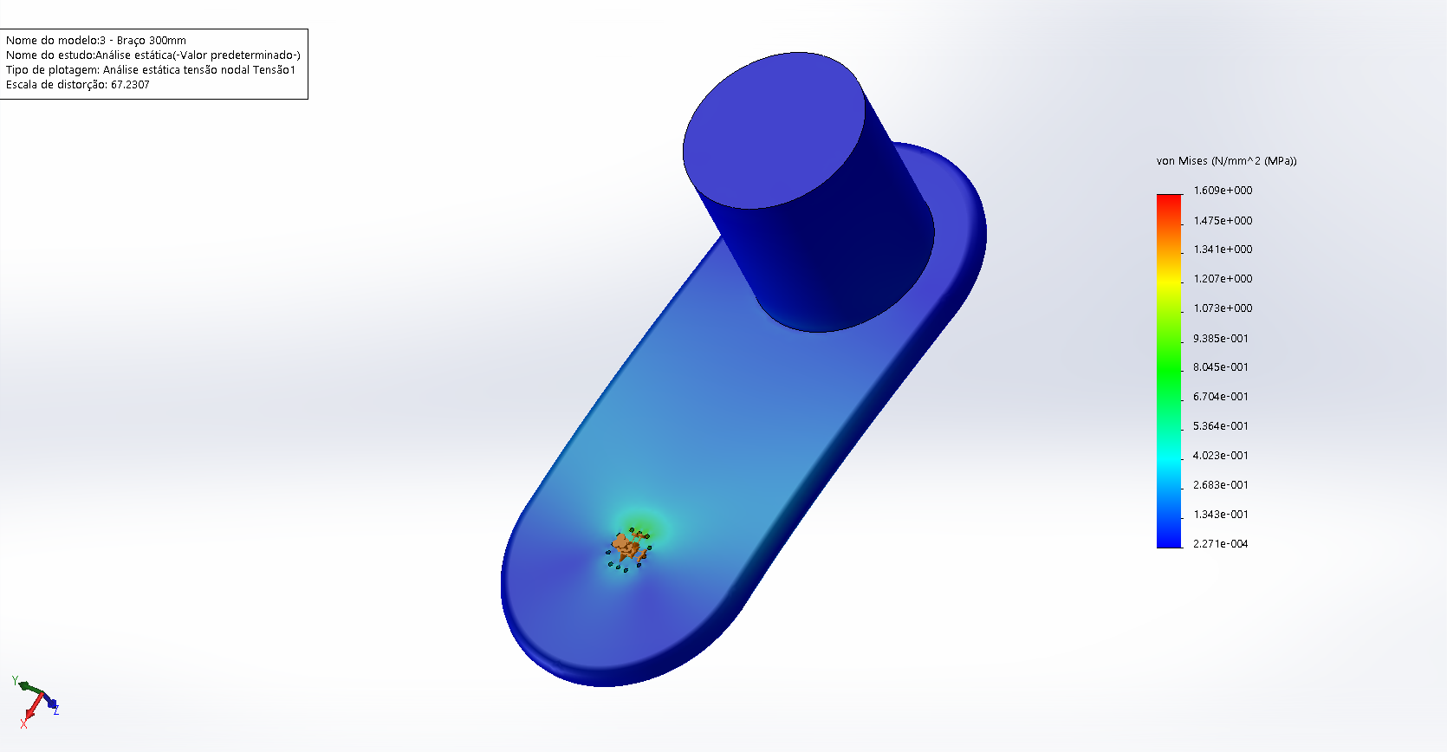
diversos/3 - Braço 300mm-Análise estática-Resultados-Tensão1.analysis.png
