gabref/TCC/diversos/Análise estática Braço 200mm-Resultados-Deformação1.analysis.png

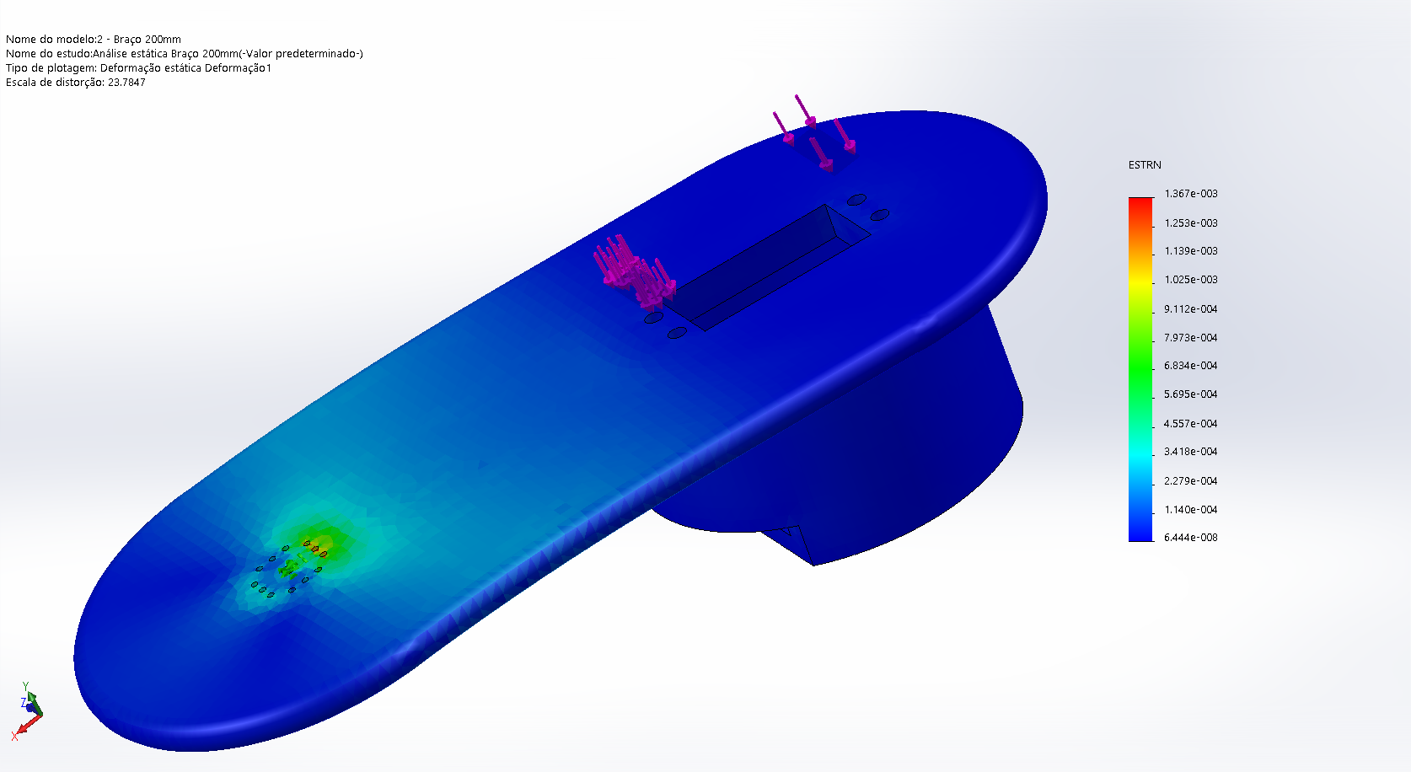
diversos/Análise estática Braço 200mm-Resultados-Deformação1.analysis.png
